Pipercat/MesseAuto/HARDWARE.md

# Hardware und Pinbelegung

## Sicherheitsregel: ESP32 ↔ Raspberry Pi

Im aktuellen MesseCar-Aufbau dürfen ESP32 und Raspberry Pi 1 **nicht dauerhaft per USB miteinander verbunden werden**.

Grund: Die USB-Verbindung verbindet die Masse des ESP32 mit der Masse des Raspberry Pi. In Verbindung mit der bestehenden Fahrzeug-/Relais-Schaltung entsteht dadurch ein unerwünschter Ground-Pfad bzw. Kurzschluss.

Deshalb gilt aktuell:

```text
ESP32 Actor  ── WLAN/MQTT ──► Raspberry Pi 1
ESP32 Sensor ── WLAN/MQTT ──► Raspberry Pi 1

USB/Serial: standardmäßig deaktivierter Fallback
```

Der vorhandene Serial-Code wird bewusst nicht gelöscht. Er darf später wieder verwendet werden, wenn der Hardwareaufbau eine sichere galvanische Trennung ermöglicht, z. B. durch geeignete Relais-/Isolationshardware ohne problematische gemeinsame Masse.

## ESP32 Actor

### Arduino-Bibliothek

- `Adafruit NeoPixel`

### Taster

| Taster | GPIO | Funktion |
|---|---:|---|
| 1 | 33 | Fernlicht |
| 2 | 15 | Abblendlicht |
| 3 | 25 | Unterbodenbeleuchtung |
| 4 | 35 | Blinker links |
| 5 | 14 | Blinker rechts |
| 6 | 27 | Warnblinker |
| 7 | 34 | Lüfter |
| 8 | 13 | **Hupe** (physischer Taster, siehe MA-11-006A) |
| 9 | 26 | Reserve |
| 10 | 32 | Reserve |

Die Taster werden als aktiv LOW erwartet. Der bisherige Aufbau mit externen Pull-up-Widerständen und Kondensatoren kann weiterverwendet werden.

### Ausgänge

| Gerät | GPIO |
|---|---:|
| Lüfter | 22 |
| WS2812/NeoPixel | 0 |
| Hupen-Trigger → ESP Sensor/Aux GPIO 13 | 21 |

Der Sketch ist aktuell für 75 NeoPixel konfiguriert.

### Direkte Hupen-Leitung Actor → Sensor/Aux (real verkabelt)

Zusätzlich zum MQTT-Pfad (M11) gibt es eine **direkte Hardware-Verbindung** zwischen den beiden ESP32: Actor-GPIO 21 ist fest mit Sensor/Aux-GPIO 13 verdrahtet. Wird der Hupentaster (Actor-GPIO 13) gedrückt, soll der Actor GPIO 21 entsprechend treiben; der Sensor/Aux liest das an seinem GPIO 13 als lokalen Hupen-Trigger — unabhängig von WLAN/MQTT-Latenz. Diese Direktleitung ist ein zusätzlicher, schneller Pfad neben dem MQTT-Hupenbefehl (`messecar/horn/command`) und dem Screen-1-Button; noch nicht in Firmware umgesetzt (betrifft MA-11-006A, MA-11-007A, MA-11-010, MA-11-015).

## ESP32 Sensor/Aux

### Aktuelle Standardpins (Quelle: `esp32-codes/esp32_sensor/esp32_sensor.ino`)

| Sensor | Pin |
|---|---:|
| Temperatur (analog LM35/TMP36) | GPIO 35 (ADC) |
| Ultraschall Trigger | GPIO 18 |
| Ultraschall Echo | GPIO 19 |
| Hupen-Trigger (Direktleitung von Actor-GPIO 21) | GPIO 13 |

Keine Pin-Kollision zwischen Sensorik (35/18/19), Hupen-Trigger (13) und MAX98357A-I2S (25/26/22).

Diese drei Pins sind als anpassbare Standardwerte gesetzt, weil für den Sensor-ESP32 bisher keine endgültige Pinbelegung dokumentiert war. Temperatur wird aktuell analog (LM35/TMP36 an ADC) ausgelesen, **nicht** per DS18B20/OneWire.

**Wichtig:** Bei einem 5-V-Ultraschallsensor darf ein 5-V-Echo-Signal nicht direkt an einen 3,3-V-ESP32-GPIO gelegt werden. Nutze einen passenden Pegelwandler oder Spannungsteiler.

### Hupen-Audio: MAX98357A (I2S), ersetzt PAM8406-Annahme aus M11

Real verkabelt (Stand: ESP Sensor/Aux angeschlossen, Hardware bestätigt):

| MAX98357A Pin | ESP32 GPIO | Funktion |
|---|---:|---|
| VIN | 5V (oder 3V3) | Spannungsversorgung (2,5–5,5V) |
| GND | GND | Masse |
| LRC | GPIO 27 | Left/Right Clock (Word Select) |
| BCLK | GPIO 25 | Bit Clock |
| DIN | GPIO 26 | Digitale Audiodaten |
| GAIN | offen | Standard 9dB Gain |
| SD | offen | Mono-Mix aus L+R |

Der MAX98357A ist ein I2S-Class-D-Verstärker mit **eingebautem DAC** — anders als der in M11 ursprünglich angenommene PAM8406 (reiner analoger Leistungsverstärker ohne DAC). Das vereinfacht MA-11-004 (Audiopfad): kein separater I2S-DAC/Codec nötig, der ESP32 gibt direkt I2S-Daten aus. MA-11-003 (PAM8406-spezifische Prüfungen: Analogeingang, Masseführung als reiner Verstärker) entfällt in der bisherigen Form und wird auf den MAX98357A angepasst.

Keine Pin-Kollision mit den bestehenden Sensor-Pins (Temperatur GPIO34, Trigger GPIO18, Echo GPIO19).

## ESP32 Dial/M10 (ESP3, Bring-up-Test)

Dritter ESP32 für den M10-Drehregler-Bring-up (siehe `TASKS.md` MA-10-001 ff.), Modul **ESP32-WROOM-32** (kein PSRAM). Firmware: `esp32-codes/esp32_dial_test/esp32_dial_test.ino`.

Aktuell nur per USB **temporär zum Flashen** an Pi 1 angeschlossen (nicht dauerhaft, siehe Sicherheitsregel oben); im festen Betrieb bekommt das Board eine eigene 5V-Versorgung.

### Magnet-Winkelsensoren (2x AS5600)

Beide AS5600 haben dieselbe I2C-Adresse 0x36 und hängen deshalb auf zwei getrennten I2C-Bussen (ESP32 `Wire`/`Wire1`), nicht an einem gemeinsamen Bus. Finale Version soll laut MA-10-003 einen TCA9548A-Multiplexer nutzen.

| Sensor | VCC | SDA | SCL | Bus |
|---|---|---:|---:|---|
| Sensor 1 | 3.3V, DIR→GND | GPIO 22 | GPIO 21 | `Wire` |
| Sensor 2 | 3.3V | GPIO 18 | GPIO 19 | `Wire1` |

Offener Punkt: Beide Sensoren melden im Status-Register das Flag „Magnet zu schwach" (AS5600 AGC-Status) — Luftspalt zum Magneten muss noch verringert bzw. ein stärkerer Magnet verbaut werden, bevor die Winkelwerte belastbar sind.

### Stepper (2x 28BYJ-48 über ULN2003)

Beide Stepper haben eine **eigene 5V-Versorgung, getrennt vom ESP32-USB-Rail** (gemeinsame Masse mit dem ESP32). Grund: Bei Versorgung über den ESP32-eigenen VIN/USB-Rail kam es real gemessen zu Spannungseinbrüchen (Brownout/Flash-Read-Error beim ESP32 selbst), sobald der Stepper Spulenstrom zog.

| Stepper | ULN2003 IN1 | IN2 | IN3 | IN4 |
|---|---:|---:|---:|---:|
| Stepper 1 | GPIO 25 | GPIO 26 | GPIO 27 | GPIO 14 |
| Stepper 2 | GPIO 32 | GPIO 4 | GPIO 16 | GPIO 17 |

### Homing und feste Referenzwinkel (Sensor1+Stepper1, Sensor2+Stepper2)

Da an keinem der beiden Regler ein mechanischer Anschlag existiert, braucht jeder Regler einen fest hinterlegten, real gemessenen Referenzwinkel statt der Boot-Position. Bei jedem Boot fährt die Firmware geschlossen-geregelt (per AS5600) aktiv zu dieser Referenz zurück ("Homing"), unabhängig davon wo der Regler zuletzt stehengeblieben ist. Grund: die vorherige Version kalibrierte bei jedem Boot neu per Testbewegung (open-loop, Rückweg nie über den Sensor verifiziert) — verlorene Schritte verschoben die Referenz bei jedem Neustart minimal.

| Regler | Referenz | Wert | Übersetzung (real gemessen) |
|---|---|---|---|
| Dial B (Sensor1+Stepper1, Geschwindigkeit 0-100%) | 0%-Referenzwinkel | raw=3901 (342,86°) | -0,0917 Grad/Schritt |
| Dial A (Sensor2+Stepper2, Fahrtrichtung LEFT/RIGHT) | RIGHT-Referenzwinkel | raw=2380 (209,18°) | -0,1261 Grad/Schritt |

Dial A: LEFT liegt 90° von RIGHT entfernt (frei gewählt), Umschaltschwelle bei 45° mit ±12° Hysterese, damit die Mittelzone kein Hin-und-Her auslöst (MA-10-009).

Real getestet (20.08.2026): nach absichtlicher Verschiebung fand Dial B beim Neustart innerhalb der 4°-Toleranz wieder zur Referenz zurück; Dial A erreichte LEFT/RIGHT jeweils mit unter 4° Restfehler.

### Bekannte Board-Eigenheit: instabile Crystal-Frequenz

`esptool` meldet bei diesem Board wiederholt `Warning: Detected crystal freq 15.55 MHz is quite different to normalized freq 26 MHz. Unsupported crystal in use?`. Dadurch schlägt die interne Hash-Verifikation nach dem Schreiben regelmäßig mit `Serial data stream stopped: Possible serial noise or corruption` fehl, obwohl der eigentliche Schreibvorgang (100% geschrieben) korrekt war. Verlässlicher Nachweis für einen erfolgreichen Flash-Vorgang ist bei diesem Board daher ein **funktionaler Boot-Test** (Reset + Serial-Log prüfen), nicht die esptool-interne Verifikation.

## Raspberry Pi 1

| Funktion | BCM GPIO |
|---|---:|
| Unterbodenbeleuchtung | 17 |
| Abblendlicht | 27 |
| Fernlicht | 25 |
| Blinker links | 6 |
| Blinker rechts | 5 |
| Lüfter | 22 |

Die GPIOs geben nur kurze Impulse aus. Ein erneuter Impuls schaltet die jeweilige externe Funktion wieder um.

## Zielverbindung

Raspberry Pi 1 soll ein lokales MesseCar-Netz bereitstellen oder darin betrieben werden. ESP32 Actor und ESP32 Sensor kommunizieren zukünftig per WLAN/MQTT mit Pi 1.

Vorteile für den aktuellen Aufbau:

- keine direkte elektrische Datenverbindung zwischen ESP und Pi
- keine zusätzliche gemeinsame Masse durch USB
- bidirektionale Kommunikation
- mehrere ESP32 ohne zusätzliche Kabel
- vollständig lokal ohne Cloud betreibbar

Die exakte MQTT-Architektur und alle Arbeitsschritte sind in `TASKS.md` definiert.

### MesseCar-WLAN (Pi 1 als Access Point, parallel zu bestehender WLAN-Nutzung)

Pi 1 besitzt einen Broadcom BCM4345/6-WLAN-Chip (`brcmfmac`), der laut `iw list` gleichzeitig **eine STA-Verbindung (managed) und einen AP** betreiben kann — allerdings nur auf **demselben Kanal** (`#channels <= 1` in den `valid interface combinations`).

Aufbau (Stand MA-01-002):

- `wlan0`: bestehende STA-Verbindung (z. B. Hotspot für SSH/Programmierung), NetworkManager-verwaltet.
- `ap0`: zusätzliche virtuelle Schnittstelle, ausschließlich für den lokalen `MesseCar`-AP, NetworkManager-unmanaged (`/etc/NetworkManager/conf.d/99-messecar-ap-unmanaged.conf`).
- SSID `MesseCar`, WPA2-PSK, Kanal **identisch mit dem aktuellen `wlan0`-Kanal** (muss bei Kanalwechsel des STA-Netzes ggf. nachgezogen werden).
- IP-Bereich `10.10.10.0/24`, Pi 1 = `10.10.10.1`, DHCP-Range `10.10.10.50–10.10.10.150` (dnsmasq).
- Kein IP-Forwarding/NAT (`net.ipv4.ip_forward=0`) — der AP bietet bewusst **keinen Internetzugang**, nur lokale Erreichbarkeit von Pi 1 (Broker folgt in MA-01-003).
- Zuständige Dienste: `messecar-ap.service` (legt `ap0` an), `messecar-hostapd.service`, `messecar-dnsmasq.service`; Konfiguration unter `/etc/hostapd/hostapd-messecar.conf` und `/etc/dnsmasq.d/messecar-ap.conf`.
- **Das WPA2-Passwort liegt bewusst nur lokal auf Pi 1 (`hostapd-messecar.conf`, Modus 600) und wird nicht in dieses öffentliche Repo committet.**

Offen: Neustart-Persistenztest von `ap0`/hostapd/dnsmasq nach echtem Pi-1-Reboot sowie realer Verbindungstest beider ESPs (folgt mit M4/M5-Firmware).

**Wichtige Falle (real aufgetreten, mehrfach):** `wlan0`/`ap0` teilen sich den Funk-Chip und müssen auf demselben Kanal laufen. Sobald `wlan0` NICHT mit einem 2,4GHz-Netz verbunden ist (z. B. weil NetworkManager automatisch zu einem bekannten 5GHz-Netz wie der Messehalle-WLAN wechselt), driftet `ap0` auf einen 5GHz-Kanal ab — die ESP32 (2,4GHz-only) können sich dann nicht mehr verbinden, ohne dass das offensichtlich ist (AP läuft scheinbar normal, nur auf falschem Band). Fix: `autoconnect=no` für alle bekannten 5GHz-Netze setzen, nur ein bekanntes 2,4GHz-Netz (z. B. Handy-Hotspot) mit hoher `autoconnect-priority` behalten, damit `wlan0` sich nicht selbstständig auf 5GHz umschaltet. Für den späteren Messebetrieb ohne verfügbaren 2,4GHz-Hotspot braucht dieses AP-Design noch eine robustere Lösung (z. B. Kanal in der hostapd-Config fest erzwingen statt an `wlan0` zu koppeln, oder zweiten WLAN-Adapter für den AP nutzen).

### MQTT-Broker (Mosquitto) auf Pi 1

- Paket `mosquitto` + `mosquitto-clients`, Systemdienst `mosquitto.service` (Standard-Debian-Unit, per Drop-in `messecar-order.conf` nach `messecar-ap.service` sortiert).
- Eigene Config `/etc/mosquitto/conf.d/messecar.conf`: Listener **ausschließlich** auf `10.10.10.1` (AP, für ESPs) und `127.0.0.1` (lokale Pi-1-App) — bewusst **nicht** auf `wlan0`/`eth0` erreichbar (getestet, Connection refused).
- `allow_anonymous true` im aktuell isolierten Lokalnetz; Zugangsschutz kann bei Bedarf später ergänzt werden.
- Port 1883, kein TLS (rein lokales Netz ohne Internetanbindung).

### Feste Boot-Zeitbasis auf Pi 1 und Pi 2

Beide Pis haben je nach WLAN-Umgebung wechselnd (mal keines, mal eines, mal beide) echtes Internet und damit unzuverlässiges NTP; die RTCs (`fake-hwclock`) liefern beim Booten unterschiedliche alte Werte. Ergebnis ohne Gegenmaßnahme: Pi 1 und Pi 2 zeigen unterschiedliche, teils stark abweichende Uhrzeiten (beobachtet: bis zu 16 Stunden Differenz).

Lösung: `systemd-timesyncd` ist auf **beiden** Pis maskiert (kein NTP), Zeitzone auf **beiden** Pis auf `UTC` gesetzt, und ein eigener Dienst `messecar-clock-baseline.service` setzt die Uhr bei jedem Boot **nach** `fake-hwclock`/`systemd-timesyncd`, aber **vor** dem jeweiligen App-Dienst, auf einen festen Anker (`2026-01-01 00:00:00 UTC`). Dadurch zählen beide Pis nach jedem Neustart ab demselben Zeitpunkt hoch (nur wenige Sekunden Boot-Zeit-Versatz zwischen den Pis, real getestet über mehrere Neustarts) statt zufälliger/abweichender Kalenderzeiten zu zeigen.

- Skript: `fahrzeugsteuerung-pi4/systemd/messecar-clock-baseline.sh` bzw. `datenbank-pi4/systemd/messecar-clock-baseline.sh` (identisch)
- Unit: `messecar-clock-baseline.service` in denselben Ordnern, `Before=messeauto.service` bzw. `Before=messeauto-database.service`
- Konsequenz: Zeitstempel in Logs/DB sind **nicht die echte Kalenderzeit**, sondern relativ zum letzten Boot. Sobald zuverlässiges Internet auf beiden Pis dauerhaft verfügbar ist, kann `systemd-timesyncd` wieder entmaskiert werden.
