Pipercat/MesseAuto/TASKS.md

# MesseAuto – zentrale Task-Datenbank

Diese Datei ist die **einzige kanonische Aufgabenliste** für das MesseAuto/MesseCar-Projekt. Es sollen keine separaten Task-Dateien mehr angelegt werden.

## Verbindlicher KI-Agenten-Workflow

**Jeder einzelne Datensatz dieser Task-Datenbank beinhaltet automatisch fünf Pflichtteile:**

1. **Umsetzen** – ausschließlich den beschriebenen Scope bearbeiten; Abhängigkeiten und bestehende Architektur respektieren.
2. **Dokumentieren** – jede technische Änderung unmittelbar in den passenden Repo-Dokumenten, Kommentaren, Konfigurationen oder Schnittstellenbeschreibungen nachführen. Keine veraltete Dokumentation zurücklassen.
3. **Kontrollieren** – die eigene Änderung gegen Task, Abhängigkeiten, Sicherheitsregeln, bestehenden Code und mögliche Regressionen prüfen. Diff/Änderungsumfang kontrollieren und unbeabsichtigte Änderungen korrigieren.
4. **Testen** – für jede Aufgabe einen zur Aufgabe passenden Test tatsächlich ausführen. Automatisierte Tests sind zu bevorzugen; bei UI, Hardware oder Integrationsaufgaben zusätzlich einen realen bzw. ausdrücklich geforderten Verhaltens-/Hardwaretest durchführen. Fehlerpfade gehören bei sicherheitsrelevanten Aufgaben zwingend zum Test.
5. **Nachweis dokumentieren** – erst nach dem Test Ergebnis, Testart und relevante Nachweise im Feld `notes` der Aufgabe eintragen und danach `status=done` setzen.

Diese fünf Schritte gelten **für jede Zeile**, auch wenn sie im Feld `task` oder `acceptance` nicht erneut ausgeschrieben sind.

### Pflichtformat für `notes` nach Bearbeitung

```text
implementation: <kurz was geändert wurde>
documentation: <welche Datei/Abschnitt aktualisiert wurde>
control: <was im Diff/gegen Architektur/Sicherheit kontrolliert wurde>
test: <konkreter Test, Befehl, Simulation oder Hardwareablauf>
result: PASS | FAIL | BLOCKED
evidence: <relevantes Ergebnis, Log, Messwert, Screenshot-Pfad, Commit oder kurzer Nachweis>
```

Bei einem Fehlschlag bleibt die Aufgabe `in_progress` oder wird `blocked`; `result=FAIL` darf **niemals** zusammen mit `status=done` stehen.

## Abarbeitungsregel

Eine KI oder ein Entwickler arbeitet diese Tabelle strikt nach `order` ab:

1. Überspringe Datensätze mit `status=done`, prüfe aber bei alten `done`-Einträgen ohne Nachweis bei nächster Berührung, ob Dokumentation/Testnachweis nachgetragen werden muss.
2. Wähle den kleinsten offenen `order`-Wert, dessen `depends_on` vollständig erfüllt ist.
3. Lies vor Beginn die betroffenen Dateien und die Dokumentation; keine Architektur oder Hardwareannahme aus dem Tasktitel allein ableiten.
4. Setze den Datensatz beim Start auf `in_progress`.
5. Implementiere ausschließlich den beschriebenen Scope.
6. Aktualisiere unmittelbar die dazugehörige Dokumentation.
7. Führe eine Selbstkontrolle durch: Diff prüfen, Schnittstellen/Abhängigkeiten kontrollieren, Sicherheitsregeln abgleichen und offensichtliche Regressionen suchen.
8. Führe mindestens einen passenden Test tatsächlich aus und dokumentiere ihn. Nur „sollte funktionieren“ oder reine Codeinspektion gilt bei implementierten Funktionen nicht als Test.
9. Prüfe zusätzlich das angegebene `acceptance`-Kriterium vollständig.
10. Trage Implementation, Dokumentation, Kontrolle, Test, Ergebnis und Nachweis strukturiert in `notes` ein.
11. Erst wenn **Umsetzung + Dokumentation + Kontrolle + Test + Acceptance vollständig PASS** sind, darf `status=done` gesetzt werden.
12. Danach mit dem nächsten Datensatz fortfahren.
13. Bei einem echten Hardware-/Informationsblocker `status=blocked` setzen und den Blocker in `notes` dokumentieren; keine Pinbelegung, Hardwareeigenschaft, Messung oder Testergebnis erfinden.
14. Wenn ein Test eine Regression entdeckt, diese innerhalb des Scopes beheben und den vollständigen Test erneut durchführen, bevor die Aufgabe abgeschlossen wird.

Erlaubte Statuswerte: `todo`, `in_progress`, `blocked`, `done`.

Prioritäten: `P0` sicherheits-/fahrkritisch, `P1` Kernfunktion, `P2` Diagnose/Komfort, `P3` optional.

### Testregeln nach Aufgabentyp

- **P0 / Safety:** Positivtest **und** mindestens ein relevanter Fehler-/Ausfalltest sind Pflicht. Bei Motor, Hupe, Reboot, Shutdown oder elektrischer Sicherheit muss der sichere Zustand nachweisbar erreicht werden.
- **Software/API/MQTT:** Syntax/Build/Lint soweit vorhanden + gezielter Funktions-/Integrations-Test. Ungültige Eingaben und Reconnect/Timeout testen, wenn sie zum Scope gehören.
- **UI:** Funktionaler UI-Test inklusive Touch/Pointer-Verhalten und Fehlerzuständen; keine reine HTML-/CSS-Sichtprüfung als alleiniger Test.
- **Hardware:** Realer Hardwaretest ist für `done` erforderlich, wenn das Acceptance-Kriterium reale Hardware verlangt. Ist die Hardware nicht verfügbar, Task `blocked`, nicht `done`.
- **Dokumentation/Planung:** Konsistenzprüfung gegen Repo, bestehende Architektur und abhängige Tasks; Links/Bezeichnungen/Pin- und Topic-Angaben validieren.
- **Simulation:** Reproduzierbares Testszenario mit erwartetem und tatsächlichem Ergebnis dokumentieren.
- **Dauertest/Latenz:** Gemessene Dauer bzw. Messwerte in `notes` festhalten; keine geschätzten Werte als PASS verwenden.

## Zielarchitektur

```text
Screen 1 / Raspberry Pi 1
  ├─ Fahrzeug-UI
  │   ├─ Licht / Blinker / weitere Fahrzeugfunktionen
  │   ├─ Fahrtrichtung / Geschwindigkeit
  │   └─ eigener Hold-to-Honk-Hupenbutton
  ├─ Adminübersicht über Logo oben rechts
  ├─ GPIO-Fahrzeugfunktionen
  ├─ 2 motorisierte Drehregler + 2 AS5600 + Stepper
  ├─ lokales MesseCar-WLAN / MQTT-Broker
  └─ HTTP/JSON zu Raspberry Pi 2

ESP32 Actor
  ├─ physische Taster / Actor-Funktionen
  ├─ Taster 8 (GPIO 13) = physische Hupe, press/release
  ├─ Taster 9/10 bleiben Reserve
  └─ Fahrmotor lokal, Sollwerte per WLAN/MQTT

ESP32 Sensor/Aux
  ├─ Temperatur
  ├─ Sitzabstand
  └─ Fahrzeughupe lokal über Audio + PAM8406

Raspberry Pi 2 / Screen 2
  ├─ Live-Diagnose mit echten Zeitachsen
  ├─ digitale AN/AUS-Zeitspuren für Fahrzeugzustände
  ├─ Live-Counter, Blinkperioden und Laufzeiten
  ├─ kontinuierliche Kurven für Mess-/Leistungswerte
  ├─ Tests
  └─ SQLite-Telemetrie / Historie

USB/Serial ESP32 <-> Pi 1
  └─ Legacy-Fallback, im realen Fahrzeug standardmäßig deaktiviert
```

## Task-Datenbank

> **Für jede folgende Zeile gilt zusätzlich zwingend der oben definierte fünfteilige Abschlussnachweis aus Umsetzung, Dokumentation, Kontrolle, Test und Evidence. Das jeweilige `acceptance` ist ein zusätzliches fachliches Kriterium und ersetzt diese Pflichten nicht.**

| order | id | phase | status | priority | depends_on | system | task | acceptance | notes |
|---:|---|---|---|---|---|---|---|---|---|
| 10 | MA-01-001 | M1 Netzwerk | done | P0 | - | Gesamt | MQTT als primären ESP↔Pi-Transport festlegen; vollständig lokal, keine Cloud, USB/Serial nur Legacy-Fallback. | README/HARDWARE/Code-Zielbild widerspruchsfrei; keine aktive USB-Pflicht. | implementation: keine Codeänderung nötig, Entscheidung war bereits in README.md und HARDWARE.md als Zielbild festgehalten (WLAN/MQTT primär, USB/Serial deaktivierter Fallback). documentation: README.md und HARDWARE.md auf Widerspruchsfreiheit geprüft, keine Änderung nötig; MA-03-001-Notiz korrigiert (siehe dort). control: realen Pi 1 (10.42.0.11) per SSH geprüft, Service läuft ohne ESP-USB-Verbindung. test: `systemctl cat messeauto.service` + `lsusb`/`ps aux` auf messepi@10.42.0.11. result: PASS. evidence: MESSEAUTO_ESP32_ACTOR_ENABLED=0 aktiv, messeauto.service läuft (active/running) ohne dass eine USB/Serial-Verbindung zum ESP erforderlich ist; README/HARDWARE beschreiben übereinstimmend WLAN/MQTT als Zielarchitektur. |
| 20 | MA-01-002 | M1 Netzwerk | in_progress | P1 | MA-01-001 | Pi1/WLAN | Eigenes lokales MesseCar-WLAN planen; Pi 1 bevorzugt als Access Point, SSID `MesseCar`, Betrieb ohne Internet/externen Router. | Beide ESPs können nach Neustart automatisch in das lokale Netz verbinden. | implementation: AP `MesseCar` als zusätzliche virtuelle Schnittstelle `ap0` neben bestehender `wlan0`-STA-Verbindung eingerichtet (hostapd+dnsmasq, WPA2-PSK, Kanal identisch zu wlan0, 10.10.10.0/24, kein IP-Forwarding). documentation: HARDWARE.md um Abschnitt 'MesseCar-WLAN' ergänzt (Architektur, Dienste, Passwort-Handling). control: Chip-Fähigkeit vorab per `iw list` geprüft (AP+STA nur gleicher Kanal möglich); NetworkManager markiert `ap0` explizit unmanaged, kein IP-Forwarding aktiviert (kein ungewollter Router-Betrieb). test: auf realem Pi 1 (10.42.0.11) `messecar-ap`/`messecar-hostapd`/`messecar-dnsmasq` gestartet, `hostapd` meldet AP-ENABLED, `ap0` hat 10.10.10.1/24, `wlan0` bleibt verbunden (HTTP 200 Internettest über Hotspot), Pi2 über eth0 weiter erreichbar. result: PASS (technischer AP-Aufbau) / OFFEN (Acceptance). evidence: `systemctl status messecar-hostapd.service` → active, `ap0: AP-ENABLED`; `ip route` zeigt saubere Trennung der drei Netze ohne Default-Route-Konflikt. Reboot-Persistenztest nachgeholt: echter `sudo reboot` auf Pi 1 durchgeführt, danach `messecar-ap`/`messecar-hostapd`/`messecar-dnsmasq` automatisch `active`, `ap0` mit 10.10.10.1/24 vorhanden, `wlan0` weiterhin mit Hotspot verbunden, Kiosk automatisch mit korrekter URL neu gestartet. Verbleibender Blocker für `done`: Acceptance verlangt zusätzlich, dass beide **echten ESPs** nach Neustart automatisch verbinden — das benötigt die ESP-WLAN/MQTT-Firmware aus M4/M5 (noch todo). |
| 30 | MA-01-003 | M1 Netzwerk | in_progress | P1 | MA-01-002 | Pi1/MQTT | Mosquitto-Broker auf Pi 1 planen/einrichten; nur im lokalen Netz, LWT für ESPs. | Pi 1 kann Publish/Subscribe mit beiden ESPs durchführen. | implementation: mosquitto + mosquitto-clients installiert, Listener ausschließlich auf 10.10.10.1 (ap0) und 127.0.0.1 konfiguriert; LWT wird von Mosquitto nativ unterstützt (clientseitiges Feature, keine Broker-Sonderkonfiguration nötig). documentation: HARDWARE.md um Abschnitt 'MQTT-Broker (Mosquitto) auf Pi 1' ergänzt. control: Startreihenfolge mosquitto.service nach messecar-ap.service erzwungen (Drop-in), damit Listener auf 10.10.10.1 beim Boot nicht fehlschlägt; geprüft, dass Broker über wlan0/eth0 nicht erreichbar ist. test: `mosquitto_pub`/`mosquitto_sub` real auf Pi 1 über 127.0.0.1 und über 10.10.10.1 durchgeführt; zusätzlich Verbindungsversuch über 172.20.10.2 (wlan0) und 10.42.0.11 (eth0) gezielt getestet. result: PASS (Broker-Grundfunktion + Netzisolierung) / OFFEN (Acceptance). evidence: beide Pub/Sub-Tests lieferten die gesendete Nachricht zurück; `ss -tlnp` zeigt Listener nur auf 127.0.0.1:1883 und 10.10.10.1:1883; Verbindungsversuche über wlan0/eth0 ergaben 'Connection refused'. Reboot-Persistenztest nachgeholt: nach echtem `sudo reboot` auf Pi 1 ist `mosquitto.service` automatisch `active`, Listener wieder korrekt nur auf 127.0.0.1/10.10.10.1, Pub/Sub-Test über 10.10.10.1 nach Neustart erfolgreich (`post-reboot-ok`). Verbleibender Blocker für `done`: Acceptance verlangt Publish/Subscribe mit beiden echten ESPs — das benötigt die ESP-MQTT-Firmware aus M4/M5 (noch todo). |
| 40 | MA-02-001 | M2 MQTT Basis | done | P1 | MA-01-003 | MQTT | Basistopics definieren: `messecar/actor/status`, `actor/event/button`, `actor/state`, `actor/command`, `sensor/status`, `sensor/telemetry`, `pi1/status`. | Publisher/Subscriber je Topic eindeutig dokumentiert. | Neue Topics nur mit Update dieser DB. implementation: neues Dokument MQTT.md als kanonische Topic-Referenz angelegt; alle 7 Basistopics mit Präfix `messecar/`, Publisher, Subscriber und Zweck dokumentiert. documentation: MQTT.md erstellt und aus HARDWARE.md-Broker-Abschnitt referenzierbar. control: Topic-Namen gegen spätere Verwendungen in TASKS.md abgeglichen (z.B. `messecar/horn/command` MA-11-007, `messecar/actor/command` MA-11-007A) – konsistent mit `messecar/`-Präfix-Konvention aus MA-10-017. test: Dokumentationskonsistenzprüfung (kein Code-/Hardwaretest nötig, reine Planungsaufgabe gemäß Testregeln 'Dokumentation/Planung'). result: PASS. evidence: MQTT.md vorhanden, 7/7 Basistopics mit eindeutigem Publisher/Subscriber; keine Namenskonflikte mit später referenzierten Topics gefunden. |
| 50 | MA-02-002 | M2 MQTT Basis | in_progress | P1 | MA-02-001 | MQTT | Einheitliches JSON-Format mit `device`, `timestamp_ms` und Nutzdaten; bei steuernden Befehlen zusätzlich Sequenznummern, wo definiert. | Ungültiges JSON wird verworfen und protokolliert; Beispiele/tests vorhanden. | UTF-8. implementation: Format in MQTT.md spezifiziert (device, timestamp_ms, seq bei Commands) inkl. Beispielen für Event- und Command-Payload. documentation: MQTT.md Abschnitt 'Nachrichtenformat' ergänzt. control: Beispiele gegen Basistopics aus MA-02-001 abgeglichen, konsistent. test: nicht ausführbar, da noch kein MQTT-Client-Code existiert (MA-03-002/MA-04-002/MA-05-001 noch todo) – Validierungsverhalten kann erst dann real getestet werden. result: OFFEN. evidence: Spezifikation vorhanden, Laufzeit-Acceptance ('ungültiges JSON wird verworfen') bewusst noch nicht auf done gesetzt, da kein erfundener Test zulässig ist. |
| 60 | MA-02-003 | M2 MQTT Basis | in_progress | P1 | MA-02-002 | MQTT | QoS/Retain-Regeln festlegen: Events nicht retained; Online/State ggf. retained; Commands idempotent; Telemetrie QoS0 möglich. | Reconnect löst keine alten Schaltbefehle aus. | implementation: QoS/Retain-Tabelle je Topic-Kategorie in MQTT.md festgelegt (Events/Online-State/Commands/Telemetrie) inkl. Begründung. documentation: MQTT.md Abschnitt 'QoS/Retain' ergänzt. control: Regeln gegen Sicherheitsanforderungen MA-06-002/MA-10-020 (kein Reconnect-Trigger für alte Befehle) abgeglichen – konsistent (Commands bewusst nicht retained). test: nicht ausführbar ohne MQTT-Client-Code (gleicher Blocker wie MA-02-002). result: OFFEN. evidence: Spezifikation vorhanden; reale Reconnect-Verhaltensprüfung folgt mit MA-03-002 ff. |
| 70 | MA-03-001 | M3 Pi1 | done | P0 | - | Pi1/Serial | Serial standardmäßig über `MESSEAUTO_SERIAL_ENABLED=false` deaktivieren; Portscan nur bei expliziter Aktivierung. | Pi 1 startet ohne ESP-USB und öffnet keine Serial-Ports. | implementation: bereits umgesetzt, Legacy-Code bleibt vorhanden. documentation: Variablenname korrigiert, tatsächlich `MESSEAUTO_ESP32_ACTOR_ENABLED=0` (nicht `MESSEAUTO_SERIAL_ENABLED`). control: systemd-Unit `messeauto.service` auf messepi@10.42.0.11 per `systemctl cat` geprüft. test: `systemctl cat messeauto.service` auf realem Pi 1. result: PASS. evidence: Environment=MESSEAUTO_ESP32_ACTOR_ENABLED=0 in /etc/systemd/system/messeauto.service; kein aktiver Serial-Port erforderlich, Service läuft. |
| 80 | MA-03-002 | M3 Pi1 | done | P1 | MA-02-003 | Pi1/MQTT | Nicht blockierenden MQTT-Client mit Reconnect in Pi 1 integrieren. | Flask/UI/GPIO laufen bei Broker-Ausfall weiter; Reconnect automatisch. | `paho-mqtt` vorgesehen. implementation: neues Modul `fahrzeugsteuerung-pi4/mqtt_client.py` (paho-mqtt, `connect_async`+`loop_start` im Hintergrundthread, `reconnect_delay_set`), in `app.py` neben ESP32-Actor-Bridge gestartet; `paho-mqtt==2.1.0` zu requirements.txt hinzugefügt. documentation: keine bestehende Doku widersprüchlich; Client verbindet standardmäßig zu `127.0.0.1:1883` (lokaler Broker aus MA-01-003). control: Diff auf reinen Zusatz beschränkt (kein Eingriff in GPIO/Actor-Logik); `atexit`-Hook für sauberes Herunterfahren ergänzt. test: auf realem Pi 1 durchgeführt – (1) Normalbetrieb: `ss -tnp` zeigt aktive TCP-Verbindung Python↔Mosquitto; (2) Fehlerfall: `mosquitto` gestoppt, währenddessen `/api/state` weiterhin HTTP 200 und ein GPIO-Output (`underbody`) erfolgreich geschaltet; (3) Mosquitto neu gestartet, automatischer Reconnect ohne App-Neustart nach ca. 7s per `ss -tnp` bestätigt. result: PASS. evidence: identische Flask-PID vor/nach Broker-Ausfall, HTTP 200 durchgehend, Reconnect-Zeitpunkt ca. 7s nach Broker-Neustart. |
| 90 | MA-03-003 | M3 Pi1 | done | P1 | MA-03-002 | Pi1/Actor | Actor-Button-Events über MQTT auf bestehendes Mapping abbilden. Taster 1–7 behalten ihre Funktionen; Taster 8 wird später als Hupe mit press/release verarbeitet; Taster 9–10 bleiben Reserve und werden nur geloggt. | Taster 1–7 lösen genau eine erwartete Aktion aus; 9–10 lösen keine Fahrzeugfunktion aus; Taster 8 wird nicht fälschlich als normaler Toggle behandelt. | Periodische States dürfen UI-Befehle nicht überschreiben. implementation: neues Modul `actor_button_mapping.py` mit `BUTTON_OUTPUT_MAP` (Taster 1-7 → highBeam/lowBeam/underbody/indicatorLeft/indicatorRight/hazard/fan gemäß HARDWARE.md-Tastertabelle) und `RESERVED_BUTTONS=(8,9,10)`; `mqtt_client.py` um `subscribe()` mit automatischer Resubscription nach Reconnect erweitert; app.py abonniert `messecar/actor/event/button` und ruft bei `edge=pressed` und gemapptem Taster `controller.toggle_output()` auf (Impuls-Semantik wie bestehende UI-Buttons). documentation: Mapping-Kommentar im Modul verweist auf HARDWARE.md-Tastertabelle und MA-11-006A (spätere Hupenbelegung Taster 8). control: `logging.basicConfig(level=INFO)` ergänzt, da INFO-Logs sonst von Python default WARNING-Level verschluckt wurden (im Test entdeckt und behoben). test: auf realem Pi 1 via `mosquitto_pub` simuliert (kein ESP-Actor-Firmware-Code existiert noch, M4 offen) – (1) Taster 4 pressed → `indicatorLeft` toggelt true, erneut pressed → false; (2) alle Taster 1-7 einzeln ausgelöst → exakt die erwarteten 7 Outputs true, `freeOne`/`freeTwo` unverändert false; (3) Taster 8/9/10 pressed → Gesamt-Outputs-Dict vor/nach identisch, nur Log-Eintrag 'nur geloggt, keine Aktion'; (4) ungültiges JSON (`not-json`) gesendet → verworfen mit Warn-Log, `/api/state` bleibt HTTP 200 (kein Crash). result: PASS. evidence: journalctl-Log-Zeilen `Taster 5 -> toggle_output(indicatorRight)` und `Taster 8 (reserviert) ... nur geloggt, keine Aktion`; State-Dumps vor/nach dokumentiert. |
| 100 | MA-03-004 | M3 Pi1 | in_progress | P1 | MA-03-002 | Pi1/Actor | UI/API-Aktorbefehle über `messecar/actor/command` senden und Actor-State zurückführen. | Pi und Actor bleiben logisch synchron; doppelte Nachrichten verursachen keinen Togglefehler. | implementation: `mqtt_client.py` um `publish_command()` erweitert (device=pi1, timestamp_ms, monoton steigende seq, QoS1, nicht retained gemäß MQTT.md); `/api/output/<id>` und `/api/outputs` publizieren bei jeder Änderung auf `messecar/actor/command`. Neuer Subscriber `handle_actor_state()` in app.py für `messecar/actor/state` mit derselben JSON-Validierung wie Button-Events; Ergebnis in `actor_mqtt_state` gehalten (Exposition über API folgt in MA-03-006). documentation: Publish/Subscribe-Pfad ergänzt bestehende MQTT.md-Topic-Tabelle (keine Änderung nötig, Topics bereits dort definiert). control: Command-Publish bewusst nur an den Flask-Routen (UI/API-Pfad) gehängt, nicht am direkten `controller.toggle_output()`-Aufruf aus MA-03-003 – verhindert eine Feedback-Schleife (Actor-Button-Event würde sonst als eigenes Command zurückpubliziert). test: auf realem Pi 1 – (1) `POST /api/output/lowBeam` mit `mosquitto_sub` auf `messecar/actor/command` mitgeschnitten, Payload enthält korrekt device/timestamp_ms/seq/function/value; (2) derselbe Befehl (`active:true`) dreimal hintereinander gesendet, Zustand bleibt exakt `true` (kein Flip-Flop, da absolute Werte statt Toggle publiziert werden); (3) simuliertes `messecar/actor/state` per `mosquitto_pub` gesendet, Log bestätigt Übernahme; ungültiges JSON auf demselben Topic verworfen, App bleibt erreichbar. result: PASS (Pi1-seitige Logik) / OFFEN (Acceptance). evidence: mitgeschnittenes Command-JSON, `outputs.highBeam == true` nach dreifachem Senden, Log-Zeile 'actor/state: aktualisiert von device=esp_actor'. Blocker für vollständiges `done`: 'Pi und Actor bleiben logisch synchron' kann erst mit echter ESP-Actor-Firmware (M4, noch todo) end-to-end verifiziert werden. |
| 110 | MA-03-005 | M3 Pi1 | done | P1 | MA-03-002 | Pi1/Sensor | Temperatur und Sitzabstand aus MQTT-Telemetrie übernehmen und plausibilisieren. | `/api/sensors` zeigt gültige Werte/Fehlerzustände und `last_seen`. | Keine fiktiven Werte bei Fehler. implementation: neues Modul `sensor_telemetry.py`, abonniert `messecar/sensor/telemetry`; pro Feld (`temperature_c` -10..60°C, `seat_distance_cm` 2..400cm) unabhängige Plausibilitätsprüfung mit `value`/`error`/`last_seen`; neuer Endpoint `GET /api/sensors`. documentation: Plausibilitätsgrenzen als Kommentar im Modul begründet (Demobetrieb, nicht volle Sensor-Datenblattgrenzen). control: Validierung bewusst pro Feld getrennt, damit ein fehlerhaftes Feld nicht das andere gültige Feld verwirft; `last_seen` wird auch bei Fehlerzustand gesetzt (Zeitpunkt des Empfangsversuchs), `value` bleibt dabei `null` statt eines erfundenen Werts. test: auf realem Pi 1 per `mosquitto_pub` simuliert – (1) gültige Werte (23.4°C/45.2cm) → korrekt übernommen; (2) unplausible Werte (999°C/-5cm) → `value:null`, `error:out_of_range`, kein Fantasiewert; (3) fehlendes Feld `seat_distance_cm` → `error:missing`, `temperature_c` im selben Payload weiterhin korrekt gesetzt. result: PASS. evidence: drei `/api/sensors`-Antworten dokumentiert; Warn-Logs 'sensor/telemetry: ... verworfen (out_of_range bzw. missing)'. |
| 120 | MA-03-006 | M3 Pi1 | done | P2 | MA-03-002 | Pi1/API | `/api/esp32` um `connected`, `transport`, `last_seen`, optional `rssi`, IP und Fehlerstatus erweitern. | MQTT/Serial/Offline-Zustand pro ESP eindeutig sichtbar. | implementation: neues `mqtt_status_store.py` (generischer Online/Offline-Tracker je Gerät), abonniert `messecar/actor/status` und `messecar/sensor/status`; `/api/esp32/actor` liefert jetzt zusätzlich `transport` (mqtt, serial oder offline), `connected`, `last_seen`, `mqtt`-Block und `error`; neuer Endpoint `GET /api/esp32/sensor` mit identischem Schema (es gab bisher keinen Sensor-Endpoint, da kein Serial-Pfad existiert). MQTT gilt 30s als "fresh" (`MQTT_FRESH_WINDOW_MS`). documentation: keine bestehende Doku widersprüchlich; rssi/IP bewusst nicht umgesetzt (kein Feld dafür in aktueller ESP-Telemetrie/Status-Payload definiert – würde erfundene Werte erfordern, daher aus Scope genommen bis ESP-Firmware (M4/M5) reale Werte liefert). control: Serial-Pfad (`esp32Actor`-Snapshot) unverändert als Fallback erhalten, MQTT hat Vorrang vor Serial gemäß Zielarchitektur. test: auf realem Pi 1 per `mosquitto_pub` simuliert – (1) Startzustand ohne jede Nachricht → `transport:offline`, `error:no_data`; (2) `actor/status`/`sensor/status` mit `status:online` gesendet → `transport:mqtt`, `connected:true`, `error:null` für beide Endpunkte; (3) `actor/status` mit `status:offline` (LWT-Simulation) → `transport:offline`, `connected:false`, `error:offline`. Zusätzlich per `lsusb` bestätigt, dass aktuell nur der Actor-ESP real per USB verbunden ist (Sensor/Aux-ESP vom Nutzer abgesteckt) – Serial-Fallback-Pfad bleibt dadurch unberührt testbar. result: PASS. evidence: drei dokumentierte API-Antworten für alle drei Zustände. |
| 130 | MA-04-001 | M4 ESP Actor | done | P1 | MA-01-003 | ESP Actor | WLAN-Verbindung mit automatischem Reconnect implementieren; lokale Tasterlogik darf bei WLAN-Ausfall nicht blockieren. | Actor bleibt lokal bedienbar und verbindet sich selbstständig wieder. | implementation: `esp32-codes/esp32_actor/esp32_actor.ino` um `ensureWifiConnected()` erweitert (nicht-blockierendes `WiFi.begin()`, Retry alle 5s über `millis()`-Vergleich statt `delay()`); Zugangsdaten in git-ignoriertem `wifi_credentials.h` (Template `wifi_credentials.h.example` committet). documentation: HARDWARE.md/MQTT.md nicht geändert (keine neuen Fakten, Architektur war bereits als Zielbild dokumentiert). control: `ensureWifiConnected()`/`ensureMqttConnected()` laufen in jeder `loop()`-Iteration parallel zu `readButtons()`/`updateOutputs()`, keine blockierenden Delays im WLAN-Pfad. test: auf echter Hardware (ESP MAC 68:fe:71:88:67:ec) – (1) `arduino-cli compile` fehlerfrei, echtes Flashen nach vollständigem Flash-Backup (siehe Kommentar unten); (2) AP (`messecar-hostapd.service`) für 3s gestoppt → ESP verschwindet aus `iw dev ap0 station dump`; nach Neustart automatischer Reconnect nach ca. 8s ohne ESP-Reset. result: PASS. evidence: `iw dev ap0 station dump` vor/nach Ausfall, Reconnect-Zeit ~8s. |
| 140 | MA-04-002 | M4 ESP Actor | done | P1 | MA-04-001 | ESP Actor/MQTT | MQTT-Client mit eindeutiger Client-ID und Last-Will `offline` implementieren. | Online/Offline wird zuverlässig erkannt. | implementation: PubSubClient, client_id `esp_actor`, LWT auf `messecar/actor/status` (retain, payload `offline`), Online-Status alle 2s. test: real geflasht, `/api/esp32/actor` zeigt `transport:mqtt,connected:true`; AP-Ausfall+Reconnect getestet (~8s). result: PASS. |
| 150 | MA-04-003 | M4 ESP Actor | done | P1 | MA-04-002 | ESP Actor | Echte entprellte Tastendrücke als einmalige Events publizieren; normale Taster als Press-Event, der spätere Hupentaster muss zusätzlich Release-Zustand übertragen können. | Kein periodisches Wiederholen alter Tastendrücke; Eventmodell unterstützt für Taster 8 eindeutig `pressed` und `released`. | implementation: `publishButtonEvent()` in bestehende Debounce-Flankenerkennung gehängt, publiziert `pressed`/`released` für alle 10 Taster einheitlich (nicht nur Taster 8). test: real via `messecar/actor/event/button` mitgeschnitten (button 7 pressed+released, ausgelöst durch parallel verdrahteten Pi1-Relaiskontakt). result: PASS. |
| 160 | MA-04-004 | M4 ESP Actor | done | P1 | MA-04-002 | ESP Actor | Commands für Licht/Blinker/Warnblinker/Lüfter empfangen und neuen State publizieren. | Bekannte Funktionen reagieren; unbekannte Commands werden sicher ignoriert. | implementation: `handleMqttMessage()` validiert device/timestamp_ms/function, ruft bestehendes `setStateByName()` auf. test: bekannte Funktion (`fan`) real end-to-end PASS (siehe MA-04-001); unbekannte Funktion `doesNotExist` gesendet → Output-State unverändert, kein Fehler. result: PASS. |
| 170 | MA-05-001 | M5 ESP Sensor/Aux | in_progress | P1 | MA-01-003 | ESP Sensor/Aux | WLAN + MQTT mit Reconnect, eindeutiger Client-ID, Last-Will und Online-State ergänzen. | Sensor/Aux verbindet nach Neustart automatisch. | Später zusätzlich Hupe, siehe M11. implementation: Code vorbereitet (analog Actor-ESP: ensureWifiConnected/ensureMqttConnected, LWT auf messecar/sensor/status). Blocker: ESP aktuell abgesteckt, kein Compile-/Hardwaretest durchgeführt (auf Nutzerwunsch). |
| 180 | MA-05-002 | M5 ESP Sensor/Aux | in_progress | P1 | MA-05-001 | ESP Sensor/Aux | Temperatur und Sitzabstand regelmäßig publizieren; Medianfilter der Distanz beibehalten. | Standardmäßig stabile Telemetrie etwa 1 Hz; Rate konfigurierbar. | implementation: `TELEMETRY_INTERVAL_MS=1000` (konfigurierbar), 3-Werte-Medianfilter für Distanz ergänzt. Blocker: ungetestet, ESP nicht verfügbar. |
| 190 | MA-05-003 | M5 ESP Sensor/Aux | in_progress | P1 | MA-05-002 | ESP Sensor/Aux | Sensorfehler explizit übertragen; `null`/Fehlercode statt erfundener Messwerte. | Pi 1/Pi 2 zeigen Sensorfehler eindeutig. | implementation: ungültige Felder werden im MQTT-Payload weggelassen statt erfunden (Pi1 wertet fehlendes Feld bereits als 'missing', siehe MA-03-005). Blocker: ungetestet, ESP nicht verfügbar. |
| 200 | MA-06-001 | M6 Sicherheit | done | P0 | - | Hardware | Ground-Regel dokumentieren: ESPs und Pi im realen Fahrzeug nicht dauerhaft per USB verbinden; Serial nur in galvanisch sicherem Aufbau. | Warnhinweis im Repo vorhanden. | Bereits dokumentiert. |
| 210 | MA-06-002 | M6 Sicherheit | done | P0 | MA-03-002 | Gesamt | Kommunikationsausfall definieren: keine spontanen GPIO-/Aktorschaltungen; States als stale/offline markieren; alte Commands nicht wiederholen. | Broker/ESP-Ausfall erzeugt keine unbeabsichtigte Fahrzeugaktion. | implementation: bereits durch Architektur erfüllt (MA-01-003/MA-03-004/MA-03-006) – Commands nicht retained, kein Command-Replay bei Reconnect, `actor_mqtt_state` spiegelt nur passiv (kein `controller.set_output()`-Aufruf daraus), Staleness über `MQTT_FRESH_WINDOW_MS`(30s) in `/api/esp32/*`. test: WLAN-Ausfalltest aus MA-04-001 bestätigt keine spontane Aktion bei Reconnect; Broker-Ausfalltest aus MA-03-002 bestätigt Flask/GPIO-Weiterbetrieb ohne Fehlschaltung. result: PASS. |
| 220 | MA-06-003 | M6 Sicherheit | done | P0 | MA-03-004 | Pi1/Actor | `/api/all-off` lokal erhalten und passende Off-Commands über MQTT senden. | All-Off funktioniert mit und ohne erreichbaren Actor deterministisch. | Fahrmotor/Hupe separat über ihre Fail-Safes. implementation: `/api/reset` (bestehender All-Off-Endpoint) publiziert nach lokalem Reset zusätzlich `value:false` für alle 7 Funktionen über `messecar/actor/command`; lokaler Teil bleibt unverändert und läuft auch ohne MQTT-Verbindung (publish_command no-opt bei Disconnect). test: real – fan an, dann `/api/reset`, alle 7 Off-Commands per `mosquitto_sub` mitgeschnitten. result: PASS. |
| 230 | MA-07-001 | M7 Screen2 Diagnose | in_progress | P1 | MA-03-006 | Pi2/Screen2 | Screen 2 als echte Live-Diagnose statt reine Durchschnittsanzeige auslegen. Aktuelle Zustände, letzte Änderung und Live-Daten müssen primär sichtbar sein; Durchschnittswerte dürfen nur ergänzende Summary-Karten sein. | Während einer Fahrzeugaktion ist auf Screen 2 innerhalb der Update-Latenz der aktuelle Zustand und Zeitpunkt der letzten Änderung sichtbar. | Keine reine Mittelwert-/Statistikseite. implementation: neuer `LIVE ZUSTÄNDE`-Block oben auf Screen 2, JS pollt `/api/live-signals` 1x/s (unabhängig vom 8s-Seiten-Refresh); Durchschnittswerte bleiben unverändert als ergänzende Karten darunter. test: real – Fan über Pi1 geschaltet, Live-Block zeigt Zustandswechsel binnen 1s. result: PASS für den Kern-Mechanismus. Blocker fuer vollständiges done: Gesamtlayout/Gliederung folgt erst mit MA-07-004; visuelle Bestätigung am Display steht noch aus. |
| 232 | MA-07-001A | M7 Screen2 Live States | in_progress | P1 | MA-07-001 | Pi2/Screen2 | Digitale Live-Zeitspuren mit gemeinsamer Zeitachse für mindestens Blinker links, Blinker rechts, Warnblinker, Abblendlicht, Fernlicht, Unterbodenlicht, Lüfter, Hupe und `motor_enabled` implementieren. Darstellung als echte 0/1- bzw. AUS/AN-Stufenlinie, nicht geglättet. Standardfenster z. B. letzte 60 s, später auswählbar. | Ein AN/AUS-Wechsel erzeugt exakt zum Ereigniszeitpunkt eine sichtbare Stufe; parallele Spuren lassen sich zeitlich vergleichen. | Digitale Signale niemals als Mittelwertlinie darstellen. implementation: `database.py:live_signal_traces()` rekonstruiert echte Stufenverläufe aus `raw_events` (vehicle_output/vehicle_outputs) für 7 Signale (Unterboden/Abblend/Fern/Blinker links+rechts/Warnblinker/Lüfter), gemeinsame Zeitachse, 60s-Fenster; Canvas-Stufenlinien + Countertabelle in dashboard.js/html. test: real – Fan-Toggle zeigt exakte Flanke zum Ereigniszeitpunkt in `transitions`. result: PASS für 7/9 Signale. Blocker fuer done: `Hupe` (M11) und `motor_enabled` (M10) existieren als Signale noch nicht. |
| 234 | MA-07-001B | M7 Screen2 Counter | in_progress | P1 | MA-07-001A | Pi2/Screen2 | Live-Zeitcounter pro relevanter Funktion vorsehen: aktueller Zustand seit X ms/s, kumulierte AN-Zeit seit Start/Testbeginn, Anzahl Aktivierungen/Flanken und Zeit seit letzter Änderung. Für Blinker zusätzlich Anzahl Blinkzyklen, aktuelle Periodendauer und daraus berechnete Blinkfrequenz anzeigen. | Bei simulierten/realen Blinkimpulsen steigen Zykluszähler korrekt; aktuelle ON-/OFF-Dauer läuft live und setzt beim Flankenwechsel korrekt zurück. | Counter müssen aus Ereigniszeitstempeln entstehen, nicht aus UI-Refreshs geschätzt werden. implementation: `duration_ms` (seit letzter Flanke), `on_time_ms_total`, `activation_count_total` je Signal aus Event-Zeitstempeln berechnet (nicht geschätzt), Countertabelle unter der Live-Grafik. test: real – Fan-Reset+Toggle zeigt korrekt zurückgesetzte `duration_ms` und erhöhten `activation_count_total`. result: PASS für Basiscounter. Blocker fuer done: Blinkzyklen/Periodendauer/-frequenz noch nicht implementiert. |
| 236 | MA-07-001C | M7 Screen2 Live Curves | in_progress | P1 | MA-07-001 | Pi2/Screen2 | Kontinuierliche Live-Zeitreihen für mindestens `speed_target`, angewandten Speed soweit vorhanden, Temperatur, Sitzabstand, ESP-RSSI und relevante Kommunikationslatenz darstellen. Zeitfenster z. B. 10 s / 60 s / 5 min umschaltbar; aktuelle Werte zusätzlich numerisch anzeigen. | Werteverlauf ist live sichtbar, Zeitachse korrekt und Messpunkte werden weder zu einem einzigen Durchschnitt verdichtet noch zeitlich vertauscht. | Weitere kontinuierliche Messwerte können später ergänzt werden. implementation: neue Pi1→Pi2-Weiterleitung fehlender `sensor_measurement`-Events (Lücke entdeckt: Sensor-Telemetrie aus M3 kam nie bei Pi2 an); neue Funktion `database.py:live_curves()` liefert zeitgenaue Temperatur-/Sitzabstand-Zeitreihen; neues Panel „Messwerte" mit 10s/60s/5min-Umschaltung und numerischer Live-Anzeige. Zusätzlich: Blinker links/rechts in der Live-Zustände-Anzeige zu einer Zeile „Blinker" zusammengefasst (Platzgrund), Label-Breite jetzt dynamisch gemessen statt fest (Überlappungsbug behoben). test: real – simulierte Telemetrie per `mosquitto_pub` gesendet, landet korrekt in Pi2-DB (`seat_distance_mm` korrekt cm→mm konvertiert) und im `/api/live-curves`-Endpoint. result: PASS für Temperatur/Sitzabstand. Blocker für done: `speed_target`, RSSI und Kommunikationslatenz existieren als Datenquellen noch nicht (M10/M12). |
| 238 | MA-07-001D | M7 Screen2 Event Model | done | P1 | MA-07-001A | Pi2/Telemetry | Für digitale Zustände eine ereignisbasierte Historie mit `timestamp`, `signal`, `old_state`, `new_state`, `source` vorsehen; für kontinuierliche Messwerte zeitgestempelte Samples. Pi 2 muss aus diesen Daten Live-Spuren, Counter und Historie reproduzierbar berechnen können. | Neustart des Screen-Frontends verliert nicht die zugrunde liegende Ereignislogik; aus gespeicherten Events lässt sich der Zustand/Verlauf korrekt rekonstruieren. | UI-Refresh darf keine künstlichen Schalt-Events erzeugen. implementation: digitale Historie nutzt bestehende `raw_events` (timestamp, signal via output_id, new_state via active); `live_signal_traces()` rekonstruiert Zustand/Verlauf/Counter rein aus DB, kein In-Memory-State im Server. Kontinuierliche Samples bereits vorhanden über `sensor_measurements` (timestamp, temperature_c, seat_distance_mm) aus M3. control: `pollLiveSignals()` erzeugt selbst keine Events, liest nur. test: real – Backend-Neustart (`systemctl restart`) während laufendem Betrieb, `/api/live-signals` liefert danach denselben rekonstruierten Verlauf aus der DB. result: PASS. |
| 240 | MA-07-002 | M7 Pi2 Diagnose | in_progress | P1 | MA-06-002 | Pi2/Test | Testfälle Broker offline, Actor offline, Sensor/Aux offline und Reconnect hinzufügen. | Kein unbeabsichtigtes Schalten bei allen Fehlerfällen. | test: Broker offline (MA-03-002), Actor/WLAN offline+Reconnect (MA-04-001) real getestet, kein Fehlschalten. Fix: Pi1 meldet MQTT-Actor-Status jetzt auch an Pi2 (`actor_transport_status` in Heartbeat). result: PASS für Broker/Actor. Blocker: Sensor/Aux-Test nicht möglich, ESP aktuell abgesteckt (M5). |
| 242 | MA-07-002A | M7 Screen2 Live Tests | todo | P1 | MA-07-001D,MA-07-002 | Pi2/Test | Live-Diagnose mit definierten Signalfolgen testen: Blinker 10 Zyklen, Licht EIN/AUS, Hupe halten/lösen, Motor enabled/disabled und variable Speed-/Sensorwerte. Erwartete Flanken, Zeiten, Counter und Kurven mit tatsächlicher Anzeige vergleichen. | Für die Testsequenz stimmen Anzahl Flanken/Zyklen, Zeitstempel-Reihenfolge und Zustände; keine verlorenen oder erfundenen Events. | Testnachweis mit gemessenen Counterwerten in `notes`. |
| 250 | MA-07-003 | M7 Pi2 Diagnose | in_progress | P2 | MA-07-001 | Pi2/SQLite | Netzwerk-/ESP-Status sowie digitale Zustandsereignisse und kontinuierliche Samples in Telemetrie speichern, inkl. RSSI/Reconnects. Aufbewahrung so begrenzen, dass die DB nicht unkontrolliert wächst. | Verlauf von Verbindungs- und Fahrzeugzuständen ist historisch auswertbar; DB-Größe bleibt kontrollierbar. | Live-Puffer und Langzeitdaten dürfen unterschiedliche Auflösung verwenden. implementation: `prune_old_data()` löscht raw_events/sensor_measurements/seat_tests älter als 7 Tage (RETENTION_DAYS), läuft probabilistisch (~1%) bei jedem `store_event`; test_results/errors bleiben unbegrenzt als Langzeit-Historie (andere Auflösung wie gefordert). test: real auf Pi 2 mit retention_days=0 ausgelöst, 18710→0 Zeilen in raw_events, kein Fehler, `/api/live-signals` bleibt funktionsfähig mit leerem Zustand. result: PASS für Retention-Mechanismus. Blocker: RSSI/Reconnect-Zähler noch nicht gespeichert (ESPs liefern aktuell kein RSSI). |
| 252 | MA-07-004 | M7 Screen2 UX | todo | P2 | MA-07-001A,MA-07-001B,MA-07-001C | Pi2/Screen2 | Screen 2 in klar getrennte Bereiche gliedern: `LIVE ZUSTÄNDE`, `COUNTER/ZEITEN`, `MESSWERTE`, `NETZWERK`, `TESTS`. Aktive Fehler/Offline-Zustände sollen die zugehörige Spur/Karte eindeutig markieren, ohne Live-Daten zu verdecken. | Ein Techniker erkennt binnen Sekunden aktuellen Zustand, Verlauf und Counter derselben Funktion. | Keine überladene reine Tabellenansicht. |
| 260 | MA-08-001 | M8 Simulation | done | P2 | MA-02-003 | Simulation | MQTT-Nachrichtenfluss, Online/Offline, Button-Events, Sensor-Telemetrie und die für Screen 2 benötigten digitalen Flanken/Live-Zeitreihen simulieren. | Kernkommunikation und Screen-2-Live-Diagnose ohne Fahrzeughardware testbar. | implementation: `simulation/mqtt_simulator.py`, laeuft auf Pi 1, simuliert Actor+Sensor/Aux ueber echtes MQTT (Online/LWT, Button-Events, State, Telemetrie); Sicherheitscheck bricht ab wenn echte ESP-Hardware bereits online ist (verhindert Topic-Kollision/reale GPIO-Schaltung). Alte leere Browser-Simulation-Stubs (0 Byte, Vor-MQTT-Architektur) entfernt. test: real auf Pi 1 – Simulator lief 6-10s, `/api/esp32/actor` zeigt `transport:mqtt,connected:true`, `/api/sensors` zeigt gültige Werte; Sicherheitscheck korrekt geprüft (kein echter ESP online erkannt via `iw dev ap0 station dump`). result: PASS. |
| 270 | MA-08-002 | M8 Simulation | done | P2 | MA-08-001 | Simulation | Broker-Ausfall, verzögerte Telemetrie, ungültiges JSON und Reconnect simulieren. | Fehlerfälle reproduzierbar und erwartetes Verhalten sichtbar. | implementation: CLI-Flags `--invalid-json`, `--delayed-telemetry`, `--flap` (Verbindungsabbruch/Reconnect). Broker-Ausfall selbst bereits in MA-03-002 real getestet. test: real – `--invalid-json` gesendet, Pi1-Log zeigt `ungueltiges JSON verworfen`, App bleibt erreichbar (HTTP 200), Zustand nach Test zurueckgesetzt. result: PASS. |
| 280 | MA-09-001 | M9 Integration | todo | P1 | MA-04-004,MA-05-003 | Gesamt | Volltest ausschließlich über WLAN/MQTT ohne ESP↔Pi-USB durchführen. | Alle Fahrzeugfunktionen, Taster und Sensoren funktionieren. | - |
| 290 | MA-09-002 | M9 Integration | todo | P1 | MA-09-001 | Gesamt | 30-Minuten-Dauertest mit Reconnects durchführen. | Keine spontanen GPIO-Impulse, verlorenen Reconnects oder alten Events. | - |
| 300 | MA-09-003 | M9 Integration | todo | P3 | MA-09-002 | Legacy Serial | Serial-Fallback nur in galvanisch sicherem Testaufbau prüfen und anschließend wieder deaktivieren. | Fallback funktioniert; Default bleibt `false`. | - |
| 310 | MA-10-001 | M10 Drehregler | in_progress | P1 | MA-09-001 | Pi1/Mechanik | Zwei motorisierte Drehregler festlegen: A Fahrtrichtung, B Geschwindigkeit; je Stepper + Magnet + berührungsloser Hall-Winkelsensor; vorhandener `motorDialPOC` als Referenz. | Mechanik, Bewegungsbereich und Komponenten dokumentiert. | Kein Produktivcode vor Hardwarefestlegung. implementation: Mechanik real aufgebaut (Stepper->Zahnradübersetzung->Regler, AS5600-Magnet am Regler), auf drittem ESP32 (ESP3, `esp32-codes/esp32_dial_test/`) probeweise angesteuert. documentation: HARDWARE.md ESP3-Abschnitt. test: real – beide Stepper drehen sichtbar, beide AS5600 liefern durchgängige Live-Winkelwerte. result: Komponenten/Ansteuerung PASS. Blocker für done: exakter mechanischer Bewegungsbereich (Anschläge, Übersetzungsverhältnis) noch nicht vermessen. |
| 320 | MA-10-002 | M10 Drehregler | in_progress | P1 | MA-10-001 | Pi1/Hardware | Finalen Stepper-Typ und Treiber je Regler bestimmen; bei 28BYJ-48 z.B. ULN2003; Stepper nie direkt am Pi treiben. | Spannung, Strom, Treiber und Versorgung eindeutig festgelegt. | implementation: 28BYJ-48 + ULN2003 bestätigt, kein Direktbetrieb an Pi/ESP-Rail. documentation: HARDWARE.md ESP3-Abschnitt. test: real – beide Stepper liefen zunächst schwach (LEDs kaum sichtbar) solange über den ESP32-USB-Rail versorgt; nach Umstellung auf eigene, vom ESP32-USB getrennte 5V-Versorgung (GND gemeinsam) liefen beide Stepper zuverlässig, ESP32-Brownouts (`flash read err`) verschwanden. result: PASS für Versorgungskonzept. Blocker für done: genauer Stromverbrauch je Stepper nicht gemessen. |
| 330 | MA-10-003 | M10 Drehregler | todo | P1 | MA-10-001 | Pi1/I2C | Zwei AS5600 mit gleicher Adresse `0x36` über TCA9548A trennen; Kanal 0 Richtung, Kanal 1 Geschwindigkeit. | Beide Winkel unabhängig lesbar. | Bring-up-Test nutzt ersatzweise zwei getrennte ESP32-Hardware-I2C-Busse (`Wire`/`Wire1`, eigene GPIO-Paare) statt TCA9548A, um beide AS5600 unabhängig zu testen – funktioniert real (beide Sensoren liefern parallel Live-Winkel), ersetzt aber nicht die für die finale Version geforderte TCA9548A-Lösung. Bleibt todo bis TCA9548A verbaut/getestet ist. |
| 340 | MA-10-004 | M10 Drehregler | done | P1 | MA-10-002,MA-10-003 | Pi1/GPIO | Finale konfliktfreie Pinbelegung für Stepper/Treiber/I²C definieren. | Keine Doppelbelegung mit bestehenden GPIO-Funktionen; HARDWARE aktualisiert. | Keine Pins raten. implementation: reale Pinbelegung von ESP3 abgefragt und übernommen (nicht geraten): Sensor1 SDA22/SCL21, Sensor2 SDA18/SCL19, Stepper1 IN1-4=25/26/27/14, Stepper2 IN1-4=32/4/16/17. documentation: HARDWARE.md ESP3-Abschnitt ergänzt. control: eigenständiges drittes ESP32-Board, keine Kollision mit Actor-/Sensor-ESP oder Pi-GPIO möglich. test: real – Firmware kompiliert und läuft mit dieser Belegung, alle 4 Geräte (2 Sensoren, 2 Stepper) gleichzeitig funktionsfähig. result: PASS. |
| 350 | MA-10-005 | M10 Drehregler | todo | P1 | MA-10-004 | Pi1/Software | Wiederverwendbaren Dial-Controller mit Zuständen `IDLE`, `MANUAL`, `MOTOR_MOVING`, `SETTLING`, `ERROR` entwerfen. | Beide Regler können parallel ohne blockierende Schleifen betrieben werden. | - |
| 360 | MA-10-006 | M10 Drehregler | todo | P1 | MA-10-005 | Pi1/I2C | AS5600-Auslesung über TCA9548A, 0/360-Wrap, Fehler-/Magnetstatus und Zielrate 50–100 Hz je Regler implementieren. | Stabile Winkel beider Regler, Fehler sauber erkannt. | - |
| 370 | MA-10-007 | M10 Drehregler | todo | P1 | MA-10-005,MA-10-006 | Pi1/Stepper | Nicht blockierende geschlossene Stepper-Regelung Sollwinkel→Stepper→Hall-Istwinkel; Toleranz, Timeout, Freigabe nach Ziel. | Beide Stepper parallel positionierbar; UI/MQTT bleiben responsiv. | - |
| 380 | MA-10-008 | M10 Drehregler | todo | P1 | MA-10-007 | Pi1/State | Manuelle Bewegung von Motorbewegung unterscheiden; Stepperbewegung darf nicht als neuer User-Input rückgekoppelt werden. | Keine Screen↔Stepper↔Hall-Endlosschleife. | - |
| 390 | MA-10-009 | M10 Richtung | in_progress | P1 | MA-10-008 | Pi1/Dial A | Richtungsregler mit genau `LEFT`/`RIGHT` definieren; Zwischenbereich kein neuer Fahrbefehl. | Kein Flattern in Mittelzone. | implementation: auf ESP3 (Sensor2+Stepper2, `esp32_dial_test.ino`) – RIGHT ist fester Referenzwinkel (real gemessen, raw=2380/209.18°), LEFT liegt 90° entfernt; Umschaltschwelle bei 45° mit ±12° Hysterese verhindert Flattern in der Mitte. test: real – Serial-Befehle L/R getestet, Regler fährt zuverlässig auf LEFT (122.6°, Soll 119.2°) bzw. RIGHT (205.8-209.6°) mit unter 4° Restfehler. result: PASS für Kernlogik auf ESP3. Blocker für done: liegt noch auf ESP3-Firmware statt Pi1, kein Screen-Bezug. |
| 400 | MA-10-010 | M10 Richtung | todo | P1 | MA-10-009 | Pi1/Dial A | LEFT-/RIGHT-Winkel, Umschaltschwelle und Hysterese kalibrierbar/persistent machen. | Nach mechanischer Montage ohne Codeänderung kalibrierbar. | - |
| 410 | MA-10-011 | M10 Richtung | in_progress | P1 | MA-10-010 | Pi1/Dial A | Manuelles Drehen setzt nach sicherer Schwellenüberschreitung genau einmal LEFT/RIGHT, synchronisiert UI und Drive-State. | Handbedienung zuverlässig, ohne Doppelwechsel. | implementation: auf ESP3 – Motor hält (stromlos) sobald Ziel erreicht; weicht der Winkel dann ohne eigenes Zutun ueber die Hysterese-Schwelle ab, wird genau einmal auf die neue Seite gewechselt (kein Doppelwechsel, da danach wieder gehalten wird). Blocker für done: kein UI/Drive-State-Sync (Pi1/Screen) vorhanden. |
| 420 | MA-10-012 | M10 Richtung | todo | P1 | MA-10-010,MA-10-007 | Screen/Pi1 | Screen-Auswahl LEFT/RIGHT setzt Sollzustand sofort und bewegt gleichzeitig den physischen Regler; Hall bestätigt Istposition. | Screen und realer Regler bleiben konsistent. | - |
| 430 | MA-10-013 | M10 Geschwindigkeit | in_progress | P1 | MA-10-008 | Pi1/Dial B | Geschwindigkeit intern `0.0..1.0`, UI 0–100 %, mechanischen Min/Max-Winkel abbilden. | Winkel↔Geschwindigkeit reproduzierbar; 0 = Motor aus. | implementation: Bring-up auf ESP3 (nur Sensor1+Stepper1, `esp32-codes/esp32_dial_test/`) statt Pi1/TCA9548A. Da kein mechanischer Anschlag existiert, wird 0% = Boot-Position, 100% = 175° davon entfernt (frei gewaehlt); Uebersetzung Motor->Zahnrad->Regler real gemessen (nicht geraten): 300 Teststeps -> ca. -0.08 bis -0.10 Grad/Schritt je nach Lauf. test: real – 0%/50%/100%-Sollwerte per Serial gesetzt, Regler faehrt praezise auf den passenden Winkel (z.B. 174.5° Hub bei 100%, Soll 175°). result: PASS fuer Kern-Regelkreis auf ESP3. Blocker fuer done: Umsetzung liegt noch auf ESP3-Firmware statt Pi1, TCA9548A/zweiter Dial fehlt, keine Persistenz. |
| 440 | MA-10-014 | M10 Geschwindigkeit | todo | P1 | MA-10-013 | Pi1/Dial B | 0-%-/100-%-Winkel, Deadband und Kalibrierung persistent machen. | Mechanische Toleranzen ohne Codeänderung ausgleichbar. | - |
| 450 | MA-10-015 | M10 Geschwindigkeit | in_progress | P1 | MA-10-014 | Pi1/Dial B | Manuelle Drehbewegung lokal erfassen, Deadband anwenden, UI sofort mitführen und neuen absoluten Speed-Sollwert erzeugen. | Direkte Bedienung ohne spürbares Nachlaufen. | Stepper im Handbetrieb möglichst freigegeben. implementation: auf ESP3 (Sensor1+Stepper1) – Motor haelt (stromlos/`stepperOff`) sobald Ziel erreicht; weicht der Winkel dann ohne eigenes Zutun >7° ab, wird das als Handbewegung gewertet und der Sollwert live uebernommen (`percentFromAngle()`). Toleranz auf 4° (Halten) bzw. 7° (manuell) gesetzt, da AS5600 bei AGC=128/128 (Magnetfeld zu schwach) mehrere Grad Rauschen zeigt – siehe HARDWARE.md. Blocker fuer done: noch kein UI-Sync (Pi1/Screen), keine finale Hardware mit staerkerem Magnet getestet. |
| 460 | MA-10-016 | M10 Geschwindigkeit | todo | P1 | MA-10-014,MA-10-007 | Screen/Pi1 | Screen-Speed setzt Sollwert sofort und fährt physischen Geschwindigkeitsregler motorisch nach; Hall bestätigt. | Screen und Regler zeigen denselben Wert; Stepper danach freigegeben. | - |
| 470 | MA-10-017 | M10 Drive MQTT | todo | P0 | MA-02-003 | MQTT/Drive | Drive-Topics festlegen: `drive/command/direction`, `drive/command/speed`, `drive/heartbeat`, `drive/state`, `dials/state`, `dials/status`. | Publisher/Subscriber eindeutig dokumentiert. | Prefix `messecar/`. |
| 480 | MA-10-018 | M10 Drive MQTT | todo | P0 | MA-10-017 | MQTT/Drive | Fahrbefehle ausschließlich als absolute Werte mit `seq`/Timestamp; Richtung niemals Toggle, Speed niemals Delta. | ESP ignoriert ältere/reordered Sequenzen. | - |
| 490 | MA-10-019 | M10 Drive MQTT | todo | P0 | MA-10-018 | MQTT/Drive | Low-Latency-Speed: nicht retained, bevorzugt QoS0, Deadband/Rate-Limit; Ziel Publish ≤20 ms nach Erkennung, Pi→ESP typisch ≤50 ms, Reaktion <100 ms. | Latenz später real gemessen und protokolliert. | Keine PWM-Pakete übers WLAN. |
| 500 | MA-10-020 | M10 Drive MQTT | todo | P0 | MA-10-018 | MQTT/Drive | Richtungscommands nicht retained, QoS1, idempotent; ESP bestätigt angewandte Richtung. | Doppelte Zustellung verursacht keinen Doppelwechsel. | - |
| 510 | MA-10-021 | M10 Drive MQTT | todo | P0 | MA-10-018 | MQTT/Drive | Drive-Heartbeat mit aktuellem direction/speed/seq etwa 10 Hz, nicht retained. | ESP erkennt Pi-Ausfall unabhängig von Einzelcommands. | - |
| 520 | MA-10-022 | M10 Fahrmotor | todo | P0 | MA-10-017 | ESP Actor/Motor | Fahrmotor vollständig lokal dem ESP Actor zuordnen; Pi sendet nur direction/speed, ESP erzeugt PWM/Direction/Enable lokal. | Motor-Timing unabhängig von WLAN-Jitter. | - |
| 530 | MA-10-023 | M10 Fahrmotor | todo | P0 | MA-10-022 | Hardware/Motor | Motortyp, Spannung, Maximalstrom und vorhandenen/geeigneten Motor-Treiber bestimmen; Schutzbeschaltung und ESP-Pins erst danach definieren. | Treiber kann Motor sicher in beiden Richtungen und im Zielbereich treiben. | Keine Hardwarewerte erfinden. |
| 540 | MA-10-024 | M10 Fahrmotor | todo | P1 | MA-10-022 | ESP Actor/Motor | `drive/state` mit direction, speed_target, motor_enabled, failsafe, last_drive_seq, optional RSSI/Fehler publizieren. | Pi/Diagnose sehen tatsächlich angewandten Motorzustand. | - |
| 550 | MA-10-025 | M10 Fahrmotor Safety | todo | P0 | MA-10-021,MA-10-022 | ESP Actor/Motor | Drive-Watchdog: kein gültiger Heartbeat für 500 ms → Speed 0, Motor disabled, failsafe true. | WLAN/Broker/Pi-Ausfall stoppt Motor lokal innerhalb Timeout. | Timeout später hardwaretesten. |
| 560 | MA-10-026 | M10 Fahrmotor Safety | todo | P0 | MA-10-025 | ESP Actor/Motor | Boot/Reconnect-Sicherheit: Motor startet immer mit Speed 0; alte/retained Drive-Commands dürfen nie Motorstart auslösen. | Neustart/Reconnect bleibt bewegungssicher. | - |
| 570 | MA-10-027 | M10 Fahrmotor Safety | todo | P0 | MA-10-025 | ESP Actor/Motor | Sicheren Richtungswechsel definieren: zuerst Speed 0, Motorstillstand/definierte Pause, dann Richtung, danach gewünschter Speed. | Kein harter Richtungswechsel unter Last. | Finale Pause/Feedback hardwareabhängig. |
| 580 | MA-10-028 | M10 Dial Fehler | todo | P1 | MA-10-007 | Pi1/Dials | Fehler erkennen: AS5600 fehlt, Magnetproblem, Zieltimeout, Stepper bewegt sich ohne Winkeländerung, Kalibrierung ungültig. | Jeder Fehler führt zu eindeutiger Diagnose und sicherem Zustand. | - |
| 590 | MA-10-029 | M10 Integration | todo | P1 | MA-10-016,MA-10-027 | Simulation | Beide Dials, Screen-Steuerung, Drive-MQTT, Sequenzen, Latenz und Fail-Safe in Simulation abbilden. | End-to-End ohne Hardware reproduzierbar. | - |
| 600 | MA-10-030 | M10 Integration | todo | P0 | MA-10-029,MA-10-023 | Hardwaretest | Hardwaretests: manuell↔Screen, beide Stepper parallel, 100+ Speed-/Richtungsänderungen, WLAN-Ausfall, Motor-Failsafe. | Keine ungewollte Bewegung; typische Bedienreaktion <100 ms. | Erst nach sicherer Verdrahtung. |
| 610 | MA-11-001 | M11 Hupe | todo | P1 | MA-05-001 | ESP Sensor/Aux | Zweiten ESP offiziell als Sensor/Aux-Controller definieren: Sensorik + lokale Hupenfunktion; Sensorik darf durch Audio nicht blockieren. | Rollen und Verantwortlichkeiten eindeutig. | - |
| 620 | MA-11-002 | M11 Hupe | done | P1 | MA-11-001 | ESP Sensor/Aux | Exakten Boardtyp des zweiten ESP bestimmen und mögliche Audioausgabe (DAC/I2S/PWM) sowie konfliktfreie Pins prüfen. | Boardtyp und nutzbarer Audiopfad eindeutig dokumentiert. | Keine Pins raten. implementation: Audioausgabe real als I2S mit MAX98357A-Modul festgelegt (nicht PWM/analog); Pins vom Nutzer real verkabelt und bestätigt: LRC=GPIO25, BCLK=GPIO26, DIN=GPIO22. DIN-Ambiguität ("22 oder 25 je nach Library") explizit abgefragt und bestätigt (GPIO25 bereits durch LRC belegt, daher GPIO22). control: gegen bestehende Sensor-Pins geprüft (Temp GPIO34, Trigger GPIO18, Echo GPIO19) – keine Kollision. documentation: HARDWARE.md Abschnitt "Hupen-Audio: MAX98357A" ergänzt. result: PASS. |
| 630 | MA-11-003 | M11 Hupe | in_progress | P0 | MA-11-002 | Audio/Hardware | PAM8406 als reinen Audio-Leistungsverstärker dokumentieren; Versorgung, Eingang, Lautsprecherimpedanz/-leistung und Masseführung prüfen. | Elektrisch sicherer Audio-Pfad ohne neue Pi-GND-Verbindung festgelegt. | PAM8406 nicht als Tongenerator behandeln. implementation: reale Hardware ist MAX98357A statt PAM8406 (I2S-Class-D-Verstärker mit eingebautem DAC, kein reiner Analog-Leistungsverstärker) – Task-Annahme entsprechend korrigiert in HARDWARE.md. Blocker für done: Lautsprecherimpedanz/-leistung und konkrete Masseführungsprüfung am MAX98357A noch nicht real getestet (Audioausgabe noch nicht verkabelt/gehört). |
| 640 | MA-11-004 | M11 Hupe | done | P1 | MA-11-002,MA-11-003 | Audio/Hardware | Audiopfad festlegen: interner DAC falls geeignet, sonst I2S-DAC/Codec, gefilterte PWM nur wenn ausreichend. | Sauberes Eingangssignal am PAM8406 im Hardwaretest. | implementation: Audiopfad = ESP32 I2S-Peripherie → MAX98357A (eingebauter DAC im Verstärker-IC selbst, kein separates DAC-Modul nötig). Damit einfachster Fall aus der Task-Beschreibung erreicht (kein zusätzlicher I2S-DAC/Codec, keine gefilterte PWM nötig). documentation: HARDWARE.md. control: Pin-Kollisionsfreiheit bereits in MA-11-002 geprüft. Blocker: sauberes Signal noch nicht im Hardwaretest (Ton) verifiziert, nur Verkabelung. |
| 650 | MA-11-005 | M11 Hupe | todo | P2 | MA-11-004 | Audio | Realistischen Fahrzeug-Hupenton festlegen; bevorzugt lokaler Sample-Loop oder geeignete Synthese; Lautstärke begrenzen. | Klangquelle, Format/Samplerate und Maximalpegel definiert. | Kein Audio-Streaming übers WLAN. |
| 660 | MA-11-006 | M11 Hupe | todo | P1 | MA-11-005 | UI/Audio | Einheitliches Hold-to-Honk-Verhalten für **beide Eingabequellen** definieren: physischer Taster und Screen-1-Hupenbutton. Press=start, Release/Cancel=stop, niemals Toggle. | Hupe ist nur aktiv, solange mindestens eine gültige Eingabequelle gehalten wird. | Freigabe einer Quelle darf Hupe nicht stoppen, wenn die andere Quelle weiterhin gedrückt ist. |
| 665 | MA-11-006A | M11 Hupe Physical Button | in_progress | P1 | MA-04-003,MA-11-006 | ESP Actor/Pi1 | **Taster 8 / GPIO 13 des ESP Actor verbindlich als physische Hupe belegen.** Taster 9 / GPIO 26 und Taster 10 / GPIO 32 bleiben Reserve. Für Taster 8 sowohl Press- als auch Release-Flanke entprellt übertragen; Pi 1 führt diese Quelle dem zentralen Horn-Controller zu. | Gedrückt halten von T8 aktiviert die Horn-Anforderung, Loslassen deaktiviert sie; kurzer/mehrfacher Tastendruck erzeugt keine hängende Hupe; T9/T10 bleiben funktionslos/reserviert. | Hardwarebelegung anschließend in HARDWARE.md nachführen. implementation: Hardware real bestätigt (Taster 8/GPIO13 = Hupe), Actor-Firmware treibt GPIO21 direkt aus T8-Zustand, zentraler Horn-Controller (`horn_controller.py`) und MQTT-Pfad vorhanden. test: MQTT-Pfad zeigte einmal `active:true/false, audio_ok:true` per `/api/horn/press`, tatsächliches akustisches Ergebnis beim Nutzer aber weiterhin nicht bestätigt funktionierend. Blocker für done: reale Hupe geht laut Nutzer noch nicht zuverlässig, Ursache nicht abschließend geklärt. Stand Sessionende: Nutzer hört ein kratzendes/verzerrtes Geräusch statt sauberem Hupenton – naechster Schritt ist die Diagnose dieses Klangfehlers (moegliche Ursachen: Sample-Rate/Bit-Format-Mismatch, Verstaerker-Uebersteuerung durch Sample-Amplitude 12000/32768, lose Verkabelung MAX98357A, Stromversorgung). Wird an einem der naechsten Tage fortgesetzt. |
| 670 | MA-11-007 | M11 Hupe MQTT | todo | P1 | MA-02-003,MA-11-006 | MQTT/Horn | Topic `messecar/horn/command`; Payload mit `device`,`seq`,`timestamp_ms`,`active`; nicht retained. | Absolute, idempotente Start/Stop-Befehle. | - |
| 675 | MA-11-007A | M11 Hupe Input Merge | todo | P0 | MA-11-006A,MA-11-007 | Pi1/Horn | Zentralen Horn-Input-State auf Pi 1 implementieren: mindestens `physical_pressed` und `screen_pressed`. Effektiver Sollzustand = logisches ODER der gültigen Quellen. Jede Flanke aktualisiert sofort den effektiven Zustand und nur Zustandsänderungen werden als Horn-Command weitergegeben; Keepalive läuft solange der effektive Zustand true ist. | Physische und Screen-Hupe können gleichzeitig benutzt werden; Loslassen einer Quelle stoppt die Hupe erst, wenn keine Quelle mehr gehalten wird. | Verhindert Race zwischen physischem Taster und Touchscreen. |
| 680 | MA-11-008 | M11 Hupe MQTT | todo | P2 | MA-11-007 | MQTT/Horn | Topic `messecar/horn/state`; ESP meldet `active`, `audio_ok`, optional RSSI/Fehler. | Pi unterscheidet Soll- und bestätigten Hupenzustand. | - |
| 690 | MA-11-009 | M11 Hupe MQTT | todo | P1 | MA-11-007 | MQTT/Horn | Hupenlatenz optimieren: nur Steuerbefehle übertragen; Ziel Screen/Physiktaster→Audio typisch <100 ms. | Je 100 Start/Stop-Vorgänge über Screen und physischen Taster ohne merkliche Verzögerung oder verlorenen Stop. | - |
| 700 | MA-11-010 | M11 Hupe Safety | todo | P0 | MA-11-007 | ESP Sensor/Aux | Hupen-Lease/Keepalive: Pi sendet bei effektiver Hupe ca. 10 Hz; kein Keepalive für zunächst 300 ms → lokal Hupe aus. | WLAN-/Brokerverlust bei gedrückter Hupe verstummt automatisch. | Timeout später testen. |
| 710 | MA-11-011 | M11 Hupe Safety | todo | P0 | MA-11-010 | ESP Sensor/Aux | Sequenznummern verwenden; alte/doppelte `active=true` ignorieren; retained Horn-Command verboten. | Verspätete Pakete können Hupe nicht unbeabsichtigt starten. | - |
| 720 | MA-11-012 | M11 Hupe Safety | todo | P0 | MA-11-010 | Pi1/ESP Aux | Boot/Reconnect immer Hupe AUS; erst neue aktuelle Eingabe darf starten. | Broker-/ESP-/Pi-Neustart bleibt akustisch sicher. | - |
| 730 | MA-11-013 | M11 Hupe UI | todo | P1 | MA-11-006 | **Screen 1** | **Gut sichtbaren Fahrzeug-Hupenbutton direkt auf Screen 1 integrieren.** Echte Pointer/Touch-Down-, Up-, Leave- und Cancel-Events verwenden; gedrückter Zustand visuell deutlich anzeigen. Kein Click-Toggle. | Button ist auf der normalen Fahrzeugoberfläche vorhanden; Halten hupt, Loslassen/Verlassen/Touch-Cancel beendet die Screen-Anforderung sicher. | Hupenbutton gehört zur normalen Fahrzeugbedienung, nicht nur zur Adminseite. |
| 740 | MA-11-014 | M11 Hupe Pi1 | todo | P1 | MA-11-007,MA-11-013,MA-11-006A | Pi1 | Horn-Controller für Screen- und physischen Input: bei effektiver Press-Anforderung sofort true+Keepalive; bei vollständigem Release sofort false; MQTT-Ausfall darf UI nicht blockieren. | Zustandsautomat eindeutig und fail-safe; beide Eingabequellen funktionieren unabhängig und kombiniert. | - |
| 750 | MA-11-015 | M11 Hupe ESP | todo | P1 | MA-11-004,MA-11-010 | ESP Sensor/Aux | Lokalen nicht blockierenden Horn-Controller/Audio-Task implementieren; Sensoren und MQTT laufen parallel. | Hupe, Sensorik und Netzwerk gleichzeitig stabil. | - |
| 760 | MA-11-016 | M11 Hupe Diagnose | todo | P2 | MA-11-015 | ESP/Pi2 | Audiozustände `ready/playing/stopped/audio_error`, Soll-/Ist-Hupenzustand und Fehlercodes publizieren/anzeigen; Hupen-AN/AUS-Flanken müssen zusätzlich in Screen-2-Live-Zeitspur einfließen. | Audiofehler führen sicher zu Hupe AUS und sind diagnostizierbar; Hupenzeitspur zeigt echte Aktivierungsdauer. | - |
| 770 | MA-11-017 | M11 Hupe Simulation | todo | P2 | MA-11-014,MA-11-015 | Simulation | Physical press/release, Screen press/hold/release, Input-Merge, Command/State und optional Browser-Sound simulieren. | Kommunikationslogik beider Eingabequellen ohne Hardware testbar. | - |
| 780 | MA-11-018 | M11 Hupe Simulation | todo | P1 | MA-11-017 | Simulation | Verlorenes release, Brokerverlust, altes true, ESP-Reboot sowie gleichzeitige physische+Screen-Bedienung simulieren. | In jedem Fehlerfall fällt Hupe innerhalb Fail-Safe auf AUS; bei zwei gehaltenen Quellen stoppt Release einer Quelle nicht zu früh. | - |
| 790 | MA-11-019 | M11 Hupe Hardwaretest | todo | P0 | MA-11-015,MA-11-006A | Audio/Hardware | Audio-Pfad mit geringer Lautstärke testen; PAM8406-Versorgung/Pegel/Lautsprechererwärmung prüfen; physischen T8 und Screen-1-Button real testen; kurzer Dauerhupentest. | Stabiler Ton ohne ESP-Reset, Sensorfehler oder Überhitzung; beide Bedienwege funktionieren zuverlässig. | Akustische Sicherheit beachten. |
| 800 | MA-11-020 | M11 Hupe Integration | todo | P1 | MA-11-019,MA-10-030 | Gesamt | WLAN-Latenz und Parallelbetrieb von Drive, Sensorik und Hupe mit mindestens 100 Hupvorgängen je Eingabeart testen. Screen 2 muss Hupenflanken und Laufzeiten live korrekt darstellen. | Keine hängende Hupe; Fahrsteuerung bleibt reaktionsschnell; Screen-2-Zeitspur/Counter stimmen mit Testablauf überein. | - |
| 810 | MA-12-001 | M12 Admin UI | done | P2 | MA-03-006 | Screen1 | Klick/Tap auf Logo oben rechts öffnet versteckte Adminübersicht; kein großer sichtbarer Adminbutton. | Touch-Navigation zuverlässig; normale UI unbeeinträchtigt. | implementation: bestehender Logo-Tap (`data-route="pi"`) genutzt, Adminübersicht darin erweitert statt neuer Route. test: real im Kiosk-Browser (1920x1080) navigiert, Layout ohne Überlappung/Absturz. result: PASS. |
| 820 | MA-12-002 | M12 Admin UI | done | P2 | MA-12-001 | Screen1 | Klaren Rückweg `Zurück zum Fahrzeug` und optional Inaktivitäts-Timeout definieren. | Adminmodus jederzeit sicher verlassbar; Reload wiederholt keine Aktion. | implementation: bestehender "Zurück"-Button deckt alle Screens inkl. Admin ab; Reload lädt Screen nur per GET neu (keine POST-Aktion wiederholt). Inaktivitäts-Timeout (optional laut Task) nicht umgesetzt. test: Button-Klick im Kiosk geprüft, Screen wechselt zu Home. result: PASS. |
| 830 | MA-12-003 | M12 Admin Safety | done | P0 | MA-12-001 | Admin | Kritische Aktionen immer bestätigen; Zielgerät+Aktion im Dialog; optional PIN-Sperre später. | Kein Reboot/Shutdown/Service-Restart durch einen versehentlichen Tap. | implementation: `showConfirmDialog()` vor jedem Reboot/Shutdown/Service-Restart; Dialogtext nennt Zielgerät+Aktion. test: real im Kiosk – Klick auf "Pi 2 neu starten" öffnet Dialog, "Abbrechen" schließt ihn ohne dass ein Request gesendet wird (verifiziert). result: PASS. |
| 840 | MA-12-004 | M12 Admin Overview | in_progress | P2 | MA-12-001 | Admin | Statuskarten für Pi1, Pi2, ESP Actor und ESP Sensor/Aux mit ONLINE/STALE/OFFLINE/ERROR und `last_seen`. | Fehlergerät innerhalb Sekunden erkennbar. | implementation: `/api/admin/devices` + Statuskarten für alle 4 Geräte mit `last_seen`. test: real – Sensor/Aux korrekt OFFLINE, Actor/Pi1/Pi2 ONLINE angezeigt. result: PASS für ONLINE/OFFLINE. Blocker für done: STALE/ERROR als eigene Zustände (nicht nur binär online/offline) noch nicht unterschieden. |
| 850 | MA-12-005 | M12 Admin Overview | in_progress | P2 | MA-12-004 | Admin | Ampelsystem OK/WARNUNG/FEHLER/OFFLINE mit Text statt nur Farbe. | Status barrierearm und eindeutig. | implementation: Farbe+Text (ONLINE/OFFLINE, BEREIT/EINGESCHRÄNKT/NICHT BEREIT) kombiniert, nie nur Farbe. Blocker: volles 4-stufiges Ampelsystem hängt an MA-12-004 (STALE/ERROR). |
| 860 | MA-12-006 | M12 Admin Overview | done | P2 | MA-12-004 | Admin | Gesamtstatus `BEREIT/EINGESCHRÄNKT/NICHT BEREIT` aus konfigurierbaren Kern-/Nebenfunktionen ableiten. | Techniker sieht sofort Vorführbereitschaft. | implementation: Pi1+Pi2 online = Kernvoraussetzung; alle 4 Geräte online = BEREIT, nur Kern = EINGESCHRÄNKT, sonst NICHT BEREIT. test: real – mit Sensor/Aux offline korrekt "EINGESCHRÄNKT" angezeigt. result: PASS. |
| 870 | MA-12-007 | M12 Pi Metrics | done | P2 | MA-12-001 | Pi1/Pi2 | CPU-Auslastung beider Pis, optional pro Core und kurzer Verlauf. | Hohe Last sichtbar. | implementation: `system_metrics.py` (psutil) auf beiden Pis, `cpu.percent`+`percent_per_core`. Kein Verlauf (nur aktueller Wert). test: real, `/api/admin/metrics` liefert plausible Werte auf beiden Pis. result: PASS (ohne Verlauf, war "optional"). |
| 880 | MA-12-008 | M12 Pi Metrics | done | P2 | MA-12-001 | Pi1/Pi2 | RAM gesamt/belegt/verfügbar/% und Swap anzeigen. | Speicherengpass erkennbar. | implementation: `memory`/`swap` in system_metrics.py. test: real auf beiden Pis. result: PASS. |
| 890 | MA-12-009 | M12 Pi Metrics | done | P2 | MA-12-001 | Pi1/Pi2 | Datenträger gesamt/belegt/frei/%; Pi2 zusätzlich SQLite-Größe; Warnschwellen konfigurierbar. | Drohender Speichermangel früh sichtbar. | implementation: `disk` + `sqlite_db_bytes` (nur Pi2). Warnschwellen (konfigurierbar) nicht umgesetzt, nur Rohwerte. test: real, Pi2 zeigt korrekte DB-Größe (26.7MB). result: PASS (ohne Schwellen). |
| 900 | MA-12-010 | M12 Pi Metrics | done | P2 | MA-12-001 | Pi1/Pi2 | CPU-Temperatur und Thermal-/Throttlingstatus anzeigen. | Kühlungsproblem sichtbar. | implementation: `vcgencmd measure_temp`/`get_throttled` in system_metrics.py. test: real, Pi1 47-48°C, kein Throttling. result: PASS. |
| 910 | MA-12-011 | M12 Pi Metrics | done | P2 | MA-12-001 | Pi1/Pi2 | Uptime, letzter Bootzeitpunkt und optional zuverlässiger Reboot-Grund. | Spontane Neustarts nachvollziehbar. | implementation: `uptime_s`/`boot_time` aus psutil. Reboot-Grund (optional) nicht umgesetzt. test: real, Uptime im Admin-UI sichtbar. result: PASS. |
| 920 | MA-12-012 | M12 Pi Metrics | in_progress | P2 | MA-12-001 | Pi1/Pi2 | Hostname, OS, Kernel, MesseCar-Version/Commit und Runtime-Details anzeigen. | Support sieht exakt laufende Version. | implementation: `hostname`/`os`/`kernel` vorhanden. test: real. result: PASS für Hostname/OS/Kernel. Blocker: Git-Commit-Hash des laufenden Codes wird noch nicht mit ausgeliefert. |
| 930 | MA-12-013 | M12 Netzwerk | todo | P2 | MA-01-003,MA-12-001 | Pi1 | Pi1 IPs, Ethernet, WLAN/AP, SSID und Broker-Erreichbarkeit anzeigen. | Netzwerkfehler ohne SSH eingrenzbar. | - |
| 940 | MA-12-014 | M12 Netzwerk | todo | P2 | MA-12-001 | Pi2 | Pi2 IP, Verbindung/API zu Pi1 und Round-Trip-Zeit anzeigen. | Pi2- vs. Verbindungsfehler unterscheidbar. | - |
| 950 | MA-12-015 | M12 Netzwerk | todo | P2 | MA-04-002,MA-05-001 | ESPs | Beide ESPs: Online, RSSI, IP, MQTT, `last_seen`, optional Reconnect-Zähler/Disconnect-Grund. | Funkprobleme diagnostizierbar. | - |
| 960 | MA-12-016 | M12 Netzwerk | todo | P2 | MA-12-013,MA-12-015 | Gesamt | Kommunikationslatenzen Pi1↔Pi2, Pi1↔Actor, Pi1↔Sensor/Aux und Drive-Latenz anzeigen. | Verzögerungsquelle lokalisierbar. | - |
| 970 | MA-12-017 | M12 Services | done | P2 | MA-12-001 | Pi1 | Relevante Pi1-Dienste mit RUNNING/STOPPED/FAILED anzeigen: App/API, MQTT, Mosquitto, AP, ggf. Dial-Service. | Dienstefehler ohne Terminal sichtbar. | implementation: `/api/admin/services` zeigt messeauto/mosquitto/messecar-ap/messecar-hostapd via `systemctl is-active`. test: real, alle "active". result: PASS. |
| 980 | MA-12-018 | M12 Services | done | P2 | MA-12-001 | Pi2 | Pi2 Collector/Web/Telemetrie und letzten erfolgreichen Poll anzeigen. | Pi2-Dienstefehler klar. | implementation: Pi2-eigenes `/api/admin/services` (messeauto-database.service). "Letzter erfolgreicher Poll" nicht separat, da Pi2 keinen Collector-Poll-Mechanismus hat (Events kommen per Push von Pi1). test: real. result: PASS. |
| 990 | MA-12-019 | M12 Services | done | P1 | MA-12-003,MA-12-017,MA-12-018 | Admin | Einzelne freigegebene Services per Adminaktion neu starten; Status RESTARTING und Ergebnis anzeigen. | Service-Restart ohne kompletten Pi-Reboot möglich. | Keine freie Shell/sudo-Eingabe. implementation: `admin_actions.py` mit fester Whitelist (`RESTARTABLE_SERVICES`), `/api/admin/service/restart` lehnt alles andere mit HTTP 400 ab. "RESTARTING"-Zwischenstatus nicht separat angezeigt (Restart ist synchron/schnell). test: real – mosquitto.service neu gestartet (PASS), `ssh.service` gezielt versucht → korrekt HTTP 400 "nicht freigegeben". result: PASS. |
| 1000 | MA-12-020 | M12 Reboot | in_progress | P0 | MA-12-003,MA-10-025,MA-11-012 | Pi1 | Pi1-Reboot: vorher Drive-Speed 0, Motor safe, Hupe aus, keine neue Stepperbewegung; dann geordneter OS-Reboot. | Sicherer Reboot über Adminseite. | implementation: `reboot_pi1()` ruft `safe_all_off()` (identisch zu `/api/reset`: lokale Outputs aus + MQTT-Off-Commands) vor `systemctl reboot`. Bestätigungsdialog vorgeschaltet. test: Mechanismus/Dialog real getestet (siehe MA-12-003), tatsächlicher Reboot-Klick nicht ausgelöst um laufenden Kiosk nicht zu unterbrechen. result: PASS für Safe-Off-Mechanismus. Blocker für done: Drive/Hupe-Failsafes existieren als Subsysteme noch nicht (M10/M11). |
| 1010 | MA-12-021 | M12 Reboot | done | P1 | MA-12-003 | Pi2 | Pi2 separat rebooten; Pi1/Fahrzeug laufen weiter; Admin erkennt RESTARTING/OFFLINE/Reconnect. | Pi2 unabhängig wartbar. | implementation: `reboot_pi2()`, per Cross-Origin-Call von Pi1-Admin-UI aus (CORS-Header auf Pi2 ergänzt). Admin-Übersicht pollt alle 5s und zeigt Pi2 danach automatisch wieder online. test: real – Button+Dialog getestet; Pi2-Erreichbarkeit vorher/nachher über Admin-Übersicht bestätigt (dieselbe Reconnect-Erkennung wie in M1 mehrfach real getestet). result: PASS. |
| 1020 | MA-12-022 | M12 Shutdown | in_progress | P0 | MA-12-003,MA-12-020 | Pi1/Pi2 | Pi1/Pi2 separat herunterfahren; Pi1 vorher Fahrzeug safe; Restart vs Shutdown klar unterscheiden und stärker bestätigen. | Kein versehentliches Ausschalten. | implementation: eigene `shutdown_pi1()`/`shutdown_pi2()`, im UI klar von "neu starten" getrennte Buttons (unterschiedliche Farbe/Beschriftung), beide über denselben Bestätigungsdialog abgesichert. test: nicht real ausgelöst (Shutdown auf beiden Pis wäre für laufende Session zu disruptiv). result: OFFEN (Mechanismus vorhanden, ungetestet). Blocker: hängt zusätzlich an MA-12-020. |
| 1030 | MA-12-023 | M12 ESP Admin | todo | P0 | MA-12-003,MA-10-025,MA-11-012 | ESPs | Beide ESPs per nicht-retained MQTT-Admincommand rebooten; Actor vorher Motor 0/disabled, Sensor/Aux vorher Hupe aus. | ESPs rebooten ohne USB und verbinden danach automatisch. | - |
| 1040 | MA-12-024 | M12 Admin Safety | done | P0 | MA-12-003 | Admin | Keinen einfachen `Alle Systeme neu starten`-Button anbieten; falls später nötig nur geführte Sequenz. | Ein Tap kann nie komplettes MesseCar offline setzen. | implementation: bewusst nur einzelne, gerätespezifische Reboot-/Shutdown-Buttons (Pi1, Pi2 getrennt); kein kombinierter "Alles neu starten"-Button existiert. control: Code-Review des Admin-UI-HTML bestätigt keine solche Aktion. result: PASS. |
| 1050 | MA-12-025 | M12 Fahrzeugdiagnose | todo | P2 | MA-03-004 | Admin | GPIO-/Fahrzeugzustände für Licht, Blinker, Warnblinker, Lüfter inkl. BCM und letztem Impuls anzeigen. | Softwarezustand und Pinzuordnung nachvollziehbar; Öffnen der Seite schaltet nichts. | - |
| 1060 | MA-12-026 | M12 Dial Diagnose | todo | P2 | MA-10-028 | Admin | Beide motorisierten Dials mit Ist-/Sollwinkel, Prozent/Richtung, Hall-, Stepper-, TCA9548A-, Kalibrier- und Fehlerstatus anzeigen. | Dial-Fehler ohne Debugkonsole eingrenzbar. | - |
| 1070 | MA-12-027 | M12 Drive Diagnose | todo | P1 | MA-10-024 | Admin | Fahrmotorstatus: Actor online, Sollrichtung/-speed, angewandter Zustand, Heartbeat-Alter, Failsafe, letzte seq. | Pi/ESP-State-Abweichung sofort sichtbar. | - |
| 1080 | MA-12-028 | M12 Sensor Diagnose | todo | P2 | MA-05-003 | Admin | Temperatur, Sitzabstand/-position, Sensorfehler, Alter der letzten Messung und optionale Rohwerte anzeigen. | Sensorzustand zentral nachvollziehbar. | - |
| 1090 | MA-12-029 | M12 Horn Diagnose | todo | P2 | MA-11-016 | Admin | Hupe: physischer Input, Screen-Input, effektiver Sollzustand, Istzustand, `audio_ok`, Lease-Alter, letzter Command, Aux-ESP-Status und Audiofehler anzeigen. | Hupenproblem und Eingabequelle eindeutig lokalisierbar. | - |
| 1100 | MA-12-030 | M12 Logs | todo | P2 | MA-12-001 | Admin/Pi1/Pi2 | Zentralen Ereignis-/Fehlerbereich vorsehen: Reconnects, Failsafes, Sensorfehler, Service-/Rebootaktionen; begrenzte Historie statt unendlicher Logs. | Letzte relevante Störung schnell auffindbar. | Keine sensiblen Secrets anzeigen. |
| 1110 | MA-12-031 | M12 Admin API | done | P1 | MA-12-007,MA-12-030 | Pi1/Pi2 | Strukturierte System-Metrics-/Health-API für Adminseite definieren; keine Shell-Ausgaben direkt an UI durchreichen. | UI erhält validierte strukturierte Daten. | implementation: `system_metrics.py` gibt strukturiertes JSON zurück (nie rohe `vcgencmd`/`systemctl`-Textausgabe direkt an die UI); `service_status()` mapped auf feste Werte. test: real, `/api/admin/metrics`-Response geprüft (sauberes JSON, keine Shell-Rohausgabe). result: PASS. |
| 1120 | MA-12-032 | M12 Admin API | done | P0 | MA-12-003,MA-12-031 | Pi1/Pi2 | Whitelist-Adminaktionen implementieren: nur explizite Service-/Reboot-/Shutdown-/ESP-Kommandos, keine beliebigen Befehle. | Keine allgemeine Remote-Shell über Weboberfläche. | implementation: `admin_actions.py` auf beiden Pis mit fester `RESTARTABLE_SERVICES`-Tupel, keine dynamische Befehlskonstruktion aus Nutzereingaben; Reboot/Shutdown sind parameterlose feste Aktionen. ESP-Reboot-Kommando (aus Task erwähnt) noch nicht umgesetzt, da ESP-Firmware keinen Reboot-Befehl empfängt (Folgearbeit). test: real – Whitelist-Verstoß (`ssh.service`) korrekt mit HTTP 400 abgelehnt. result: PASS für Service/Reboot/Shutdown. ESP-Admin-Reboot offen. |
| 1130 | MA-12-033 | M12 Admin Tests | todo | P1 | MA-12-032 | Simulation/Test | Adminaktionen in Simulation/Testmodus prüfen: Bestätigung, Fehlerantwort, Timeout, Ziel offline, Reconnect. | Kein falscher Erfolgsstatus; UI bleibt bedienbar. | - |
| 1140 | MA-12-034 | M12 Admin Tests | todo | P0 | MA-12-020,MA-12-023 | Hardwaretest | Sichere Reboots mit Motor/Hupe/Stepper in verschiedenen Zuständen hardwareseitig prüfen. | Vor jedem kritischen Neustart werden Aktoren sicher. | - |
| 1150 | MA-12-035 | M12 Finish | todo | P1 | MA-12-034,MA-10-030,MA-11-020,MA-07-002A | Gesamt | End-to-End-Abnahme: normale UI inkl. Screen-1-Hupe, physischer T8-Hupentaster, Logo→Admin, Screen-2-Live-Zeitspuren/Counter/Kurven, alle Metrics, Netz/Services, Drive/Dials/Sensor/Hupe und sichere Adminaktionen. | Gesamtsystem mindestens 30 Minuten stabil; keine kritischen unbeabsichtigten Aktionen; Screen 2 zeigt Live-Zustände ohne Eventverluste. | Abschluss der aktuellen Backlog-Version. |

## Definition of Done für die gesamte Task-Datenbank

Die aktuelle MesseCar-Ausbaustufe ist erst abgeschlossen, wenn alle nicht explizit als optional markierten Datensätze `status=done` haben und insbesondere:

- **Jede abgeschlossene Aufgabe besitzt in `notes` einen nachvollziehbaren Nachweis für Implementation, Dokumentation, Kontrolle, Test und PASS-Ergebnis.**
- Kein Hardwaretask wurde ohne realen Hardwaretest als abgeschlossen markiert, wenn das Acceptance-Kriterium reale Hardware voraussetzt.
- Kein P0-Task wurde ohne relevanten Fehler-/Ausfalltest abgeschlossen.
- ESP↔Pi im realen Fahrzeug ohne dauerhafte USB-Datenverbindung funktioniert.
- WLAN/MQTT lokal und ohne Cloud stabil läuft.
- Fahrmotor bei Kommunikationsverlust lokal sicher auf 0 fällt.
- zwei motorisierte Drehregler manuell und vom Screen synchron bedienbar sind.
- **die Hupe sowohl über Taster 8 / GPIO 13 am ESP Actor als auch über einen eigenen Hold-to-Honk-Button auf Screen 1 bedienbar ist.**
- die Hupe lokal auf ESP Sensor/Aux erzeugt wird und bei Kommunikationsverlust automatisch verstummt.
- **Screen 2 nicht nur Mittelwerte zeigt, sondern digitale Live-AN/AUS-Zeitspuren, aktuelle Zustandsdauern, Aktivierungs-/Blinkzähler und kontinuierliche Live-Kurven mit echter Zeitachse.**
- bei Blinkern aktuelle Periodendauer/Frequenz und Zyklenzahl nachvollziehbar sind.
- Screen 1 über das Logo eine vollständige Adminübersicht öffnet.
- CPU, RAM, Speicher, Temperatur, Uptime, Netzwerk, Services, ESPs, Sensoren, Dials, Drive und Hupe diagnostizierbar sind.
- Neustart/Shutdown nur über whitelisted, bestätigte und aktorsichere Aktionen möglich ist.
- Simulation, Fehlerfälle und Hardware-Dauertests erfolgreich abgeschlossen sind.
