Pipercat/MesseAuto/motorDialPOC 1/dial.stl

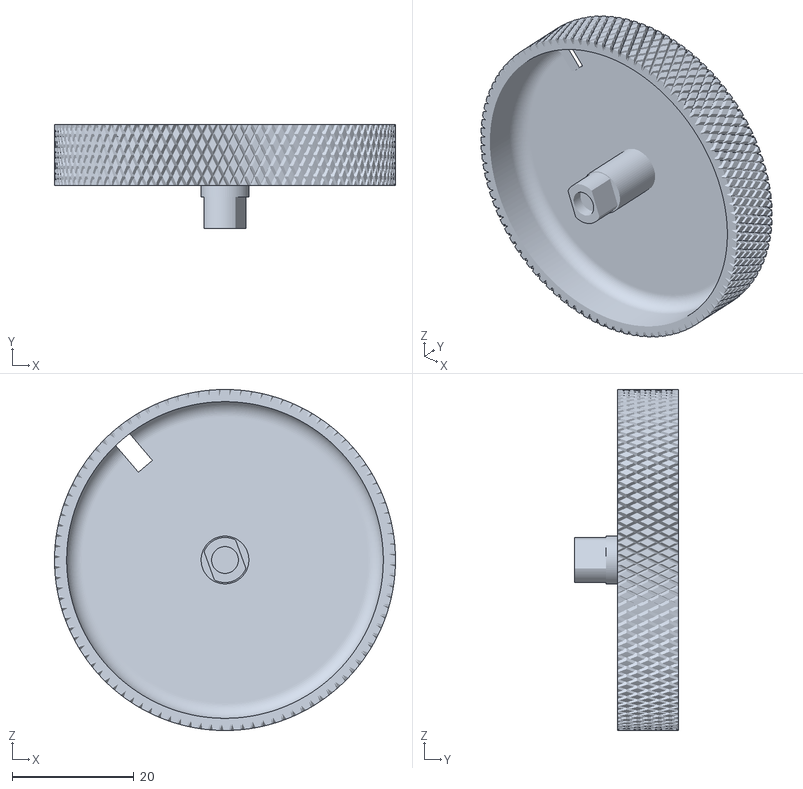
[picture p2: CAD file, 2026-08-18]
motorDialPOC 1/dial.stl
56.0 x 17.0 x 56.0
