Pipercat/MesseAuto/motorDialPOC 1/motorMountPlate.stl

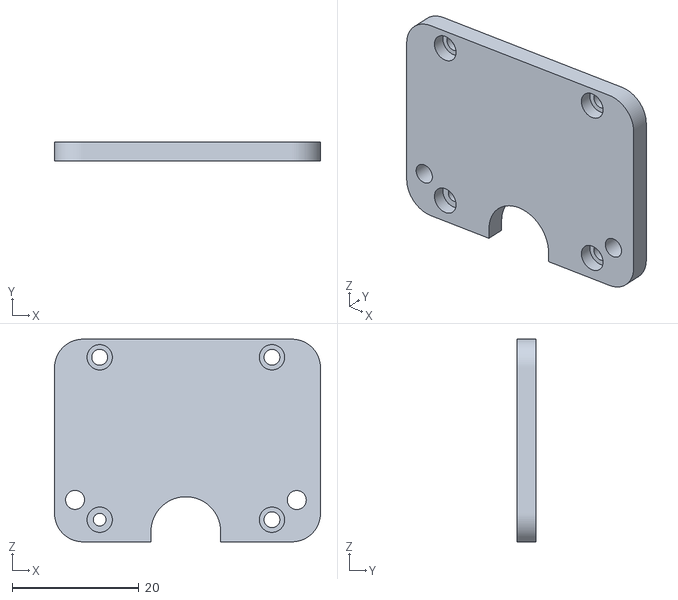
[picture p3: CAD file, 2026-08-18]
motorDialPOC 1/motorMountPlate.stl
42.0 x 3.00 x 32.0
