Pipercat/MesseAuto/motorDialPOC 1/GEARLARGE.stl

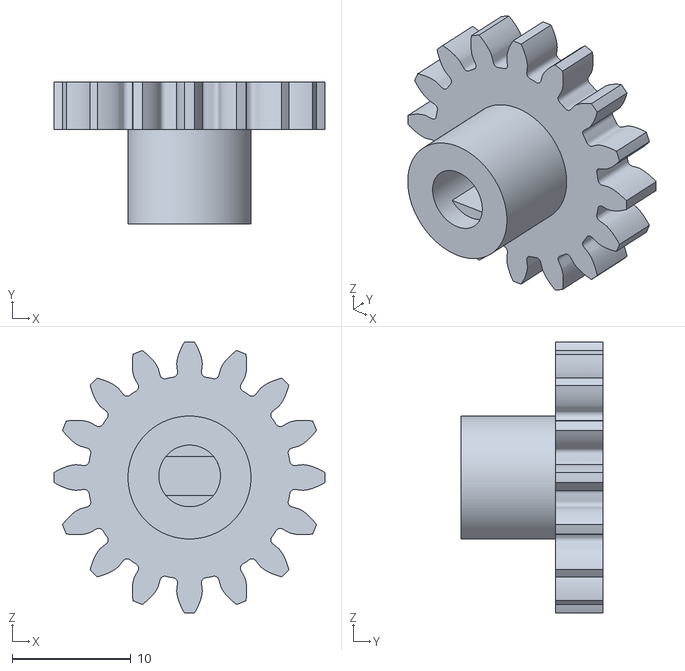
[picture p4: CAD file, 2026-08-18]
motorDialPOC 1/GEARLARGE.stl
22.9 x 12.0 x 22.9
