Pipercat/MesseAuto/motorDialPOC 1/boardcase.stl

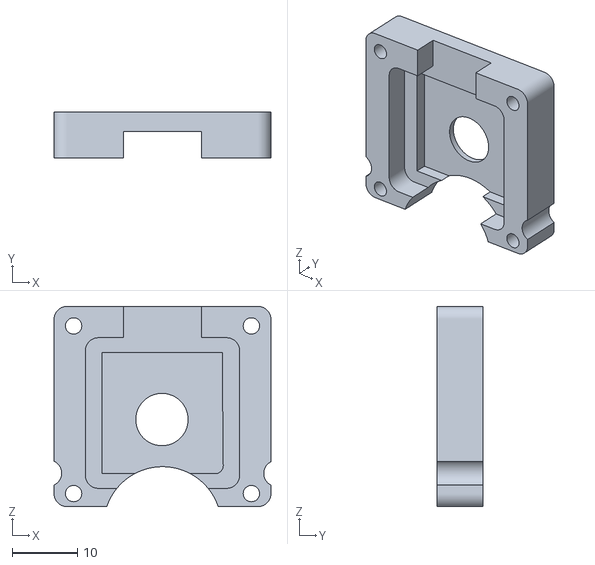
[picture p5: CAD file, 2026-08-18]
motorDialPOC 1/boardcase.stl
33.2 x 7.00 x 30.7
