Pipercat/MesseAuto/motorDialPOC 1/GEARSMALL.stl

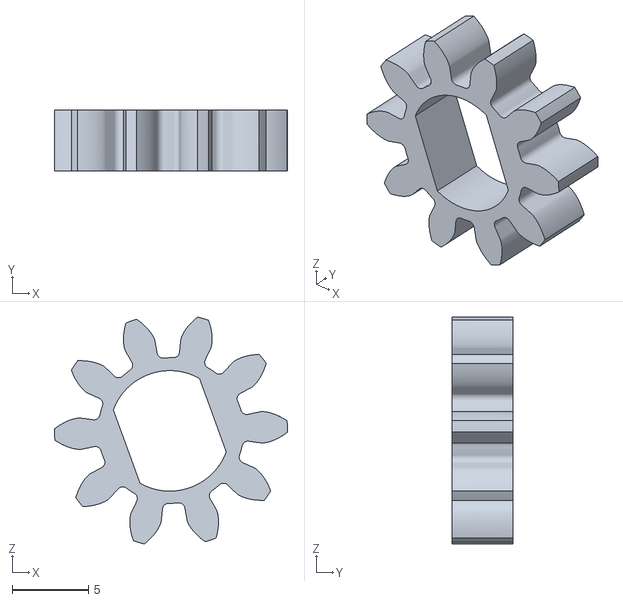
[picture p6: CAD file, 2026-08-18]
motorDialPOC 1/GEARSMALL.stl
15.2 x 4.00 x 14.8
