Pipercat/MesseAuto/motorDialPOC 1/topCover.stl

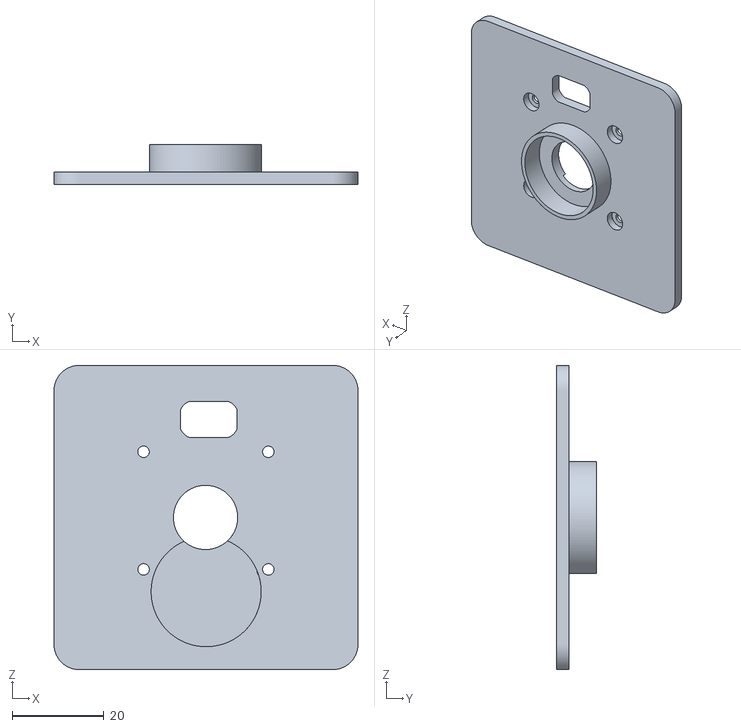
[picture p7: CAD file, 2026-08-18]
motorDialPOC 1/topCover.stl
66.3 x 8.80 x 66.3
