Pipercat/MesseAuto/motorDialPOC 1/spacer.stl

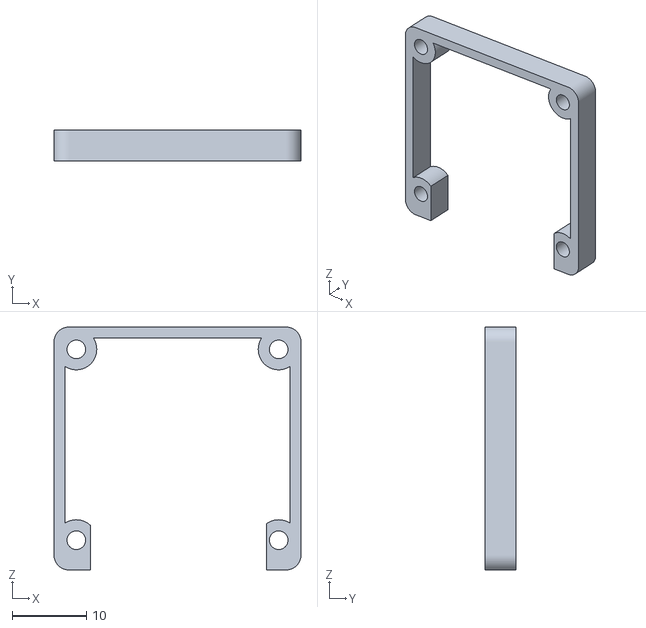
[picture p8: CAD file, 2026-08-18]
motorDialPOC 1/spacer.stl
33.2 x 4.20 x 32.7
