Pipercat/MesseAuto/motorDialPOC 1/lightRing.stl

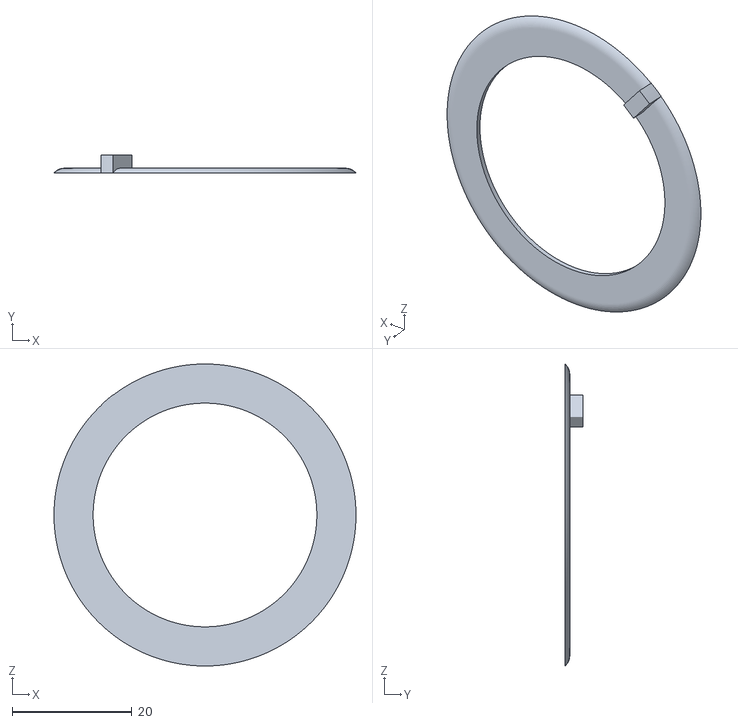
[picture p9: CAD file, 2026-08-18]
motorDialPOC 1/lightRing.stl
50.5 x 3.00 x 50.5
