Pipercat/MesseAuto/motorDialPOC 1/washer.stl

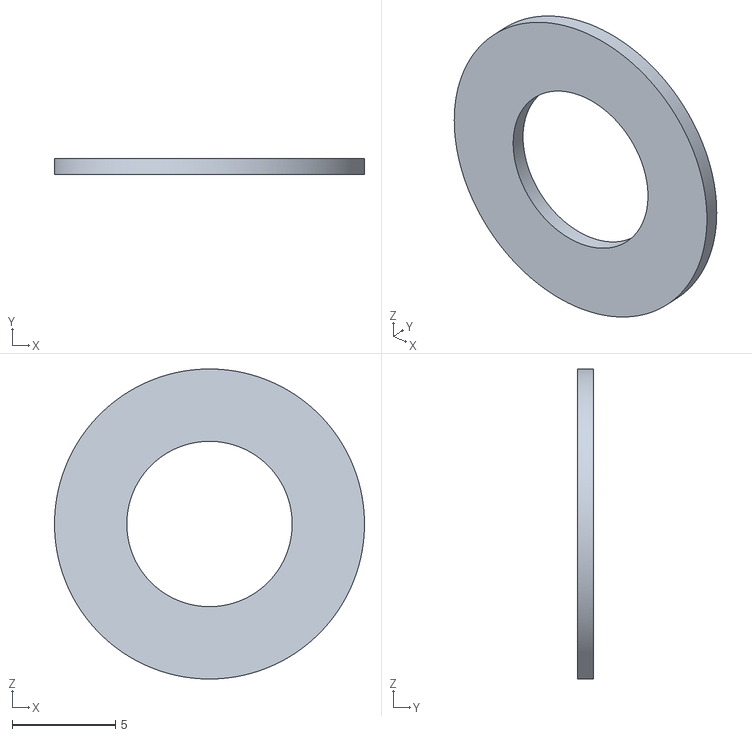
[picture p10: CAD file, 2026-08-18]
motorDialPOC 1/washer.stl
15.0 x 0.75 x 15.0
