Pipercat/MesseAuto/(commit log)

2026-07-10 Abhängigkeiten für Raspberry Pi 1 hinzufügen
2026-07-10 Code für Raspberry Pi 1 hinzufügen
2026-07-10 Code für Raspberry Pi 2 hinzufügen
2026-07-10 Abhängigkeiten für Raspberry Pi 2 hinzufügen
2026-07-10 Code für ESP32 Aktorik hinzufügen
2026-07-10 Code für ESP32 Sensorik hinzufügen
2026-07-10 Hardware- und Bibliothekshinweise ergänzen
2026-07-10 Add complete PC simulation for all MesseAuto boards
2026-07-10 Add Raspberry Pi 1 fullscreen simulation
2026-07-10 Add Raspberry Pi 2 fullscreen simulation
2026-07-10 Fix Pi 1 control flow and add complete display API
    [app.py]
2026-07-10 Fix ESP32 actor state logic and complete status protocol
    [esp32_actor.ino]
2026-07-10 Harden ESP32 sensor readings and JSON telemetry
2026-07-10 Fix simulation state handling and match real device logic
2026-07-10 Prevent stale ESP status from overriding Pi controls
    [app.py]
2026-07-10 Send explicit physical button events to Pi 1
2026-08-18 Update hardware docs for wireless ESP communication
2026-08-18 Define motorized dial and drive architecture
2026-08-18 Initial import of local MesseAuto working tree
    [GEARLARGE.stl, GEARSMALL.stl, boardcase.stl, dial.stl, lightRing.stl, motorMountPlate.stl, spacer.stl, topCover.stl]
2026-08-18 M1 Netzwerk: Reboot-Persistenztest für MesseCar-AP und Mosquitto-Broker nachgetragen
    Echter Pi-1-Neustart bestätigt: AP, Broker, Kiosk und Fahrzeugsteuerung
    kommen automatisch und korrekt wieder hoch.
2026-08-18 M3 Pi1: nicht-blockierenden MQTT-Client mit automatischem Reconnect integriert
    MA-03-002 done: neues mqtt_client.py (paho-mqtt, Hintergrundthread),
    real auf Pi 1 getestet inkl. Broker-Ausfall (Flask/GPIO liefen weiter)
    und automatischem Reconnect (~7s) ohne App-Neustart.
    [app.py, mqtt_client.py]
2026-08-18 M3 Pi1: Actor-Button-Events per MQTT auf bestehendes Mapping abgebildet
    MA-03-003 done: Taster 1-7 -> bestehende GPIO-Outputs (toggle_output),
    Taster 8-10 bewusst nur geloggt, kein Toggle. MQTT-Client um subscribe()
    mit Resubscribe-nach-Reconnect erweitert. Real auf Pi 1 per mosquitto_pub
    simuliert getestet, da ESP-Actor-Firmware noch aussteht (M4).
2026-08-18 M3 Pi1: UI/API-Aktorbefehle ueber MQTT publizieren, Actor-State-Feedback empfangen
    MA-03-004 in_progress: /api/output(s) publizieren jetzt auf
    messecar/actor/command (device/timestamp_ms/seq, QoS1, nicht retained);
    neuer Subscriber fuer messecar/actor/state. Real getestet: korrektes
    Command-Payload, keine Toggle-Fehler bei Duplikaten, State-Feedback
    funktioniert. Voll "done" erst mit ESP-Actor-Firmware aus M4.
2026-08-18 M3 Pi1: Sensor-Telemetrie aus MQTT uebernehmen und plausibilisieren
    MA-03-005 done: neues sensor_telemetry.py + GET /api/sensors.
    Temperatur/Sitzabstand je Feld unabhaengig plausibilisiert, bei
    Fehler/fehlendem Feld kein fiktiver Wert (value=null, error gesetzt).
    Real auf Pi 1 per mosquitto_pub getestet: gueltig, unplausibel, fehlend.
    [app.py, sensor_telemetry.py]
2026-08-18 M3 Pi1: /api/esp32 um MQTT/Serial/Offline-Transportstatus erweitert
    MA-03-006 done: neues mqtt_status_store.py fuer Online/Offline-Tracking
    (actor/status, sensor/status). /api/esp32/actor liefert jetzt transport/
    connected/last_seen/error; neuer Endpoint /api/esp32/sensor analog.
    Real auf Pi 1 getestet: kein Signal, MQTT-online, LWT-offline.
    Damit ist M3 Pi1 vollstaendig abgearbeitet (MA-03-001 bis MA-03-006).
    [app.py, mqtt_status_store.py]
2026-08-18 M4 ESP Actor: WLAN/MQTT-Client, Button-Events, Command-Handling (real getestet)
2026-08-18 Ignore Arduino build artifacts
2026-08-18 Pi1: MQTT-Actor-Status an Pi2 melden; Pi2: Chart-Timeline-Clipping behoben
    [app.py]
2026-08-18 M7: MA-07-002 Fehlerfall-Tests dokumentiert (Sensor/Aux offen, ESP abgesteckt)
2026-08-18 M5 ESP Sensor/Aux: WLAN/MQTT, Medianfilter und Fehlerbehandlung vorbereitet (ungetestet, ESP nicht verbunden)
2026-08-18 M8 Simulation: MQTT-Simulator fuer Actor/Sensor inkl. Fehlerfaelle, alte leere Stubs entfernt
2026-08-19 M7: Live-Kurven (Temperatur/Sitzabstand), Pi1->Pi2 Sensor-Forward, Blinker-Zeile zusammengefasst
2026-08-19 M12 Admin UI: Uebersicht, Pi-Metriken, Service-Restart, Reboot/Shutdown mit Bestaetigung
    Neue Admin-Seite (versteckt hinter Logo-Tap): Geraete-Statuskarten,
    Bereitschaftsanzeige, CPU/RAM/Disk/Temp fuer beide Pis, Dienststatus
    mit Whitelist-Restart, sicheres Reboot/Shutdown je Pi mit Bestaetigungsdialog.
    CORS-Fix auf Pi2 fuer Cross-Pi-Metriken. Alte Systemstatus-Karte auf
    Kernfelder gekuerzt, Relais/Ausgaenge-Panel durch einzelnen
    All-Off-Button ersetzt (Nutzerwunsch). Alles real getestet.
    [admin_actions.py, app.py, server.py, system_metrics.py]
2026-08-19 M11: reale Hupen-Hardware dokumentiert (MAX98357A I2S statt PAM8406), Sensor-ESP jetzt angeschlossen
2026-08-19 M11: Direktleitung Actor-GPIO21 zu Sensor/Aux-GPIO13 fuer Hupen-Trigger dokumentiert
2026-08-19 M10/M11: WLAN-AP-Kanal-Fix (ohne Hotspot-Abhaengigkeit), Hupe I2S/ADC-Bugfixes, Motor-PWM, Drehregler-Bringup
    - ap0 driftete auf 5GHz sobald wlan0 mit bekanntem 5GHz-Netz verbunden war;
    Autoconnect fuer alle Netze ausser Hotspot deaktiviert, AP haelt jetzt
    eigenstaendig Kanal 6 ohne externe Abhaengigkeit (HARDWARE.md dokumentiert)
    - Sensor/Aux: ADC-Treiberkonflikt mit legacy I2S behoben (Legacy-ADC-API statt
    analogRead), reale I2S-Pins korrigiert (LRC27/BCLK25/DIN26), DMA-Puffer wird
    beim Hupe-Ausschalten geleert (verhinderte Dauerbrummen)
    - Actor: Motor-PWM auf GPIO4 per MQTT (messecar/actor/motor/command)
    - Pi1 Screen: Motor-Slider-Layout repariert und zentriert, Hintergrundkontras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
    [actor_button_mapping.py, app.py, esp32_actor.ino, esp32_dial_test.ino, esp32_sensor.ino, horn_controller.py]
2026-08-20 M10 ESP3: festes Homing statt Pro-Boot-Rekalibrierung (Sensor1+Stepper1)
    Bisherige Pro-Boot-Kalibrierung war open-loop (300 Schritte vor, 300
    zurueck, Rueckweg nie per Sensor verifiziert) - verlorene Schritte
    verschoben die 0%-Referenz bei jedem Neustart minimal, Ursache fuer
    gelegentliches "Verdrehen". Jetzt: einmalig real gemessener fester
    Referenzwinkel (HOME_ANGLE_DEG=342.86 Grad) und Uebersetzung
    (DEG_PER_STEP=-0.0917 Grad/Schritt) im Code hinterlegt; bei jedem Boot
    faehrt der Regler aktiv und geschlossen-geregelt (per AS5600) exakt
    dorthin zurueck. Real getestet: nach Verschiebung auf 80% landete das
    Homing beim Neustart innerhalb der 4-Grad-Toleranz wieder am
    Referenzwinkel.
    Co-Autho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
2026-08-20 M10 ESP3: Fahrtrichtung LEFT/RIGHT mit Homing (Sensor2+Stepper2)
    Analog zum Geschwindigkeitsregler: fester, real gemessener RIGHT-
    Referenzwinkel (raw=2380/209.18 Grad) statt Boot-Position, aktives
    Homing bei jedem Boot. LEFT liegt 90 Grad entfernt (frei gewaehlt,
    kein Anschlag). Umschaltschwelle bei 45 Grad mit +/-12 Grad Hysterese
    verhindert Flattern in der Mittelzone (MA-10-009).
    Uebersetzung Motor->Getriebe->Regler real gemessen: -0.1261 Grad/Schritt
    (600-Schritt-Messung). Real getestet: L/R-Wechsel per Serial fuehrt
    zuverlaessig auf LEFT (122.6 Grad, Soll 119.2) bzw. RIGHT (205.8-209.6
    Grad) mit unter 4 Grad Restfehler.
